MuX2001/cad-piper-paxini-adaptor/drawings/screenshots/piper_dual_m2324-v2_mount_detail.png

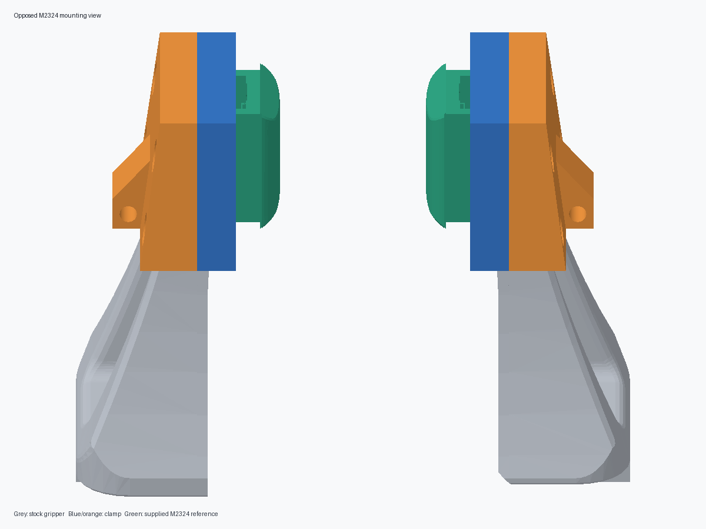
drawings/screenshots/piper_dual_m2324-v2_mount_detail.png
