MuX2001/cad-piper-paxini-adaptor/drawings/screenshots/piper_m2324-v2_section.png

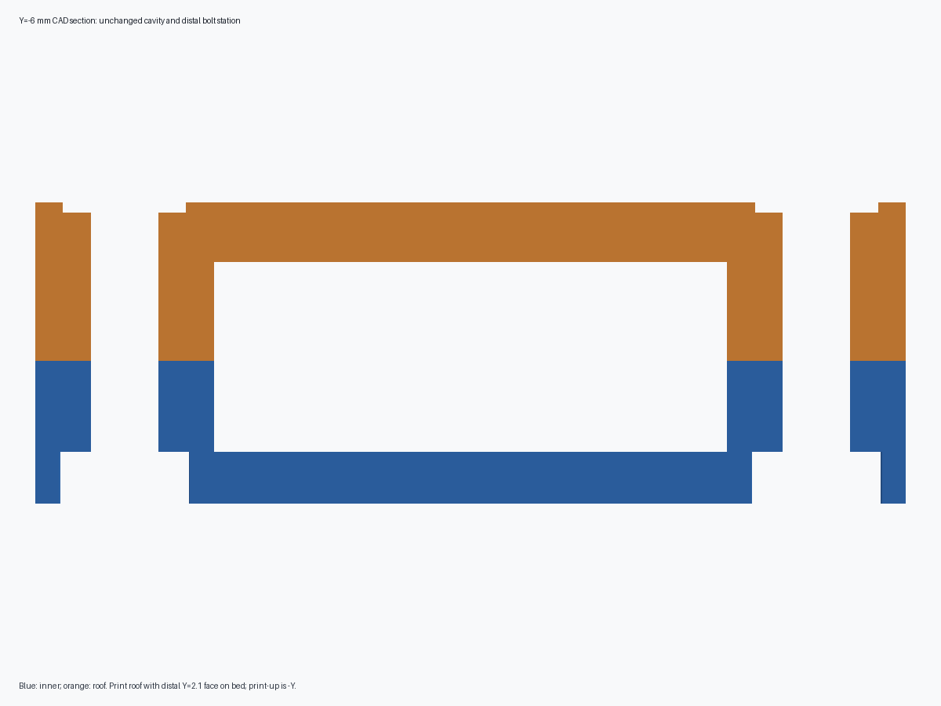
drawings/screenshots/piper_m2324-v2_section.png
