MuX2001/cad-piper-paxini-adaptor/v2/drawings/cable_routing.png

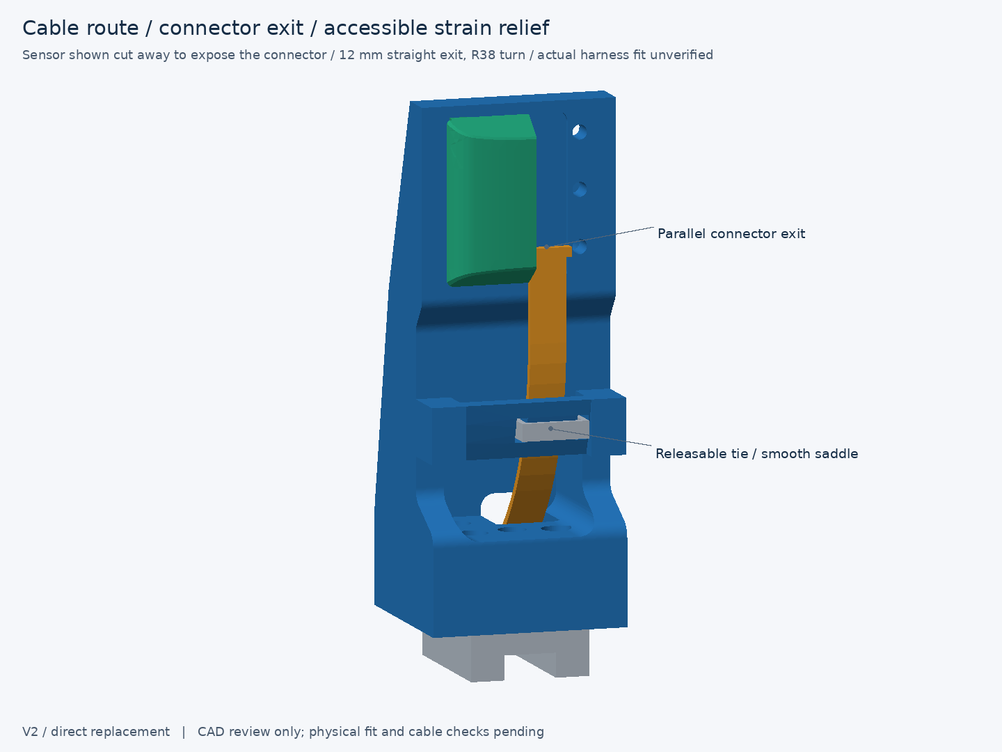
v2/drawings/cable_routing.png
