MuX2001/cad-piper-paxini-adaptor/v2/drawings/sensor_mount.png

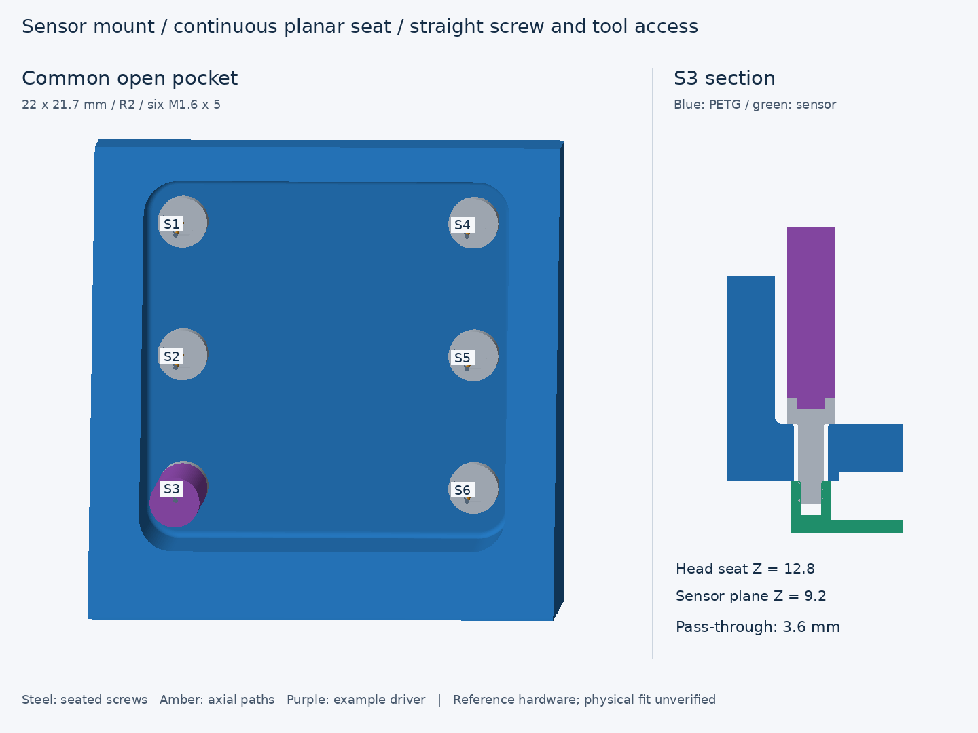
v2/drawings/sensor_mount.png
