MuX2001/cad-piper-paxini-adaptor/assets/vendor_files/agx_arm_urdf-main/agx_gripper/meshes/gripper_base.stl

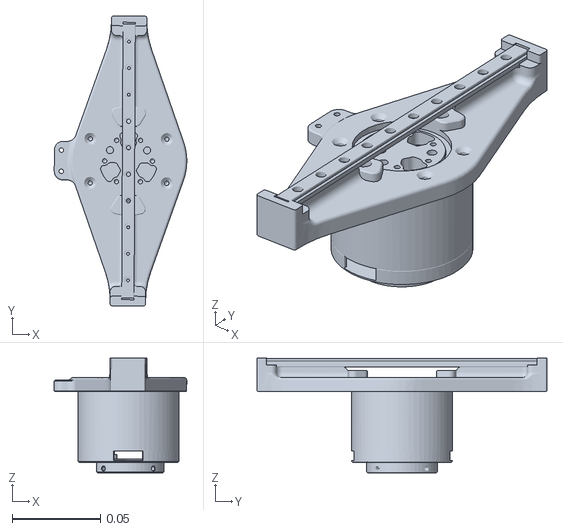
[picture p9: CAD file, 2026-10-11]
assets/vendor_files/agx_arm_urdf-main/agx_gripper/meshes/gripper_base.stl
0.075 x 0.164 x 0.065
