MuX2001/cad-piper-paxini-adaptor/assets/vendor_files/agx_arm_urdf-main/nero/meshes/link7.stl

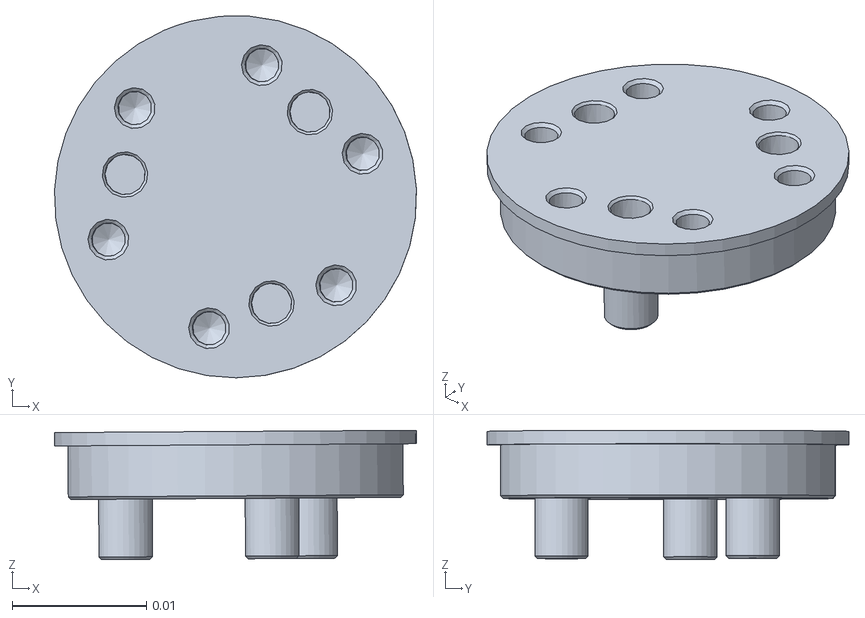
[picture p10: CAD file, 2026-10-11]
assets/vendor_files/agx_arm_urdf-main/nero/meshes/link7.stl
0.027 x 0.027 x 0.00965
