MuX2001/cad-piper-paxini-adaptor/assets/vendor_files/agx_arm_urdf-main/piper/meshes/link2.stl

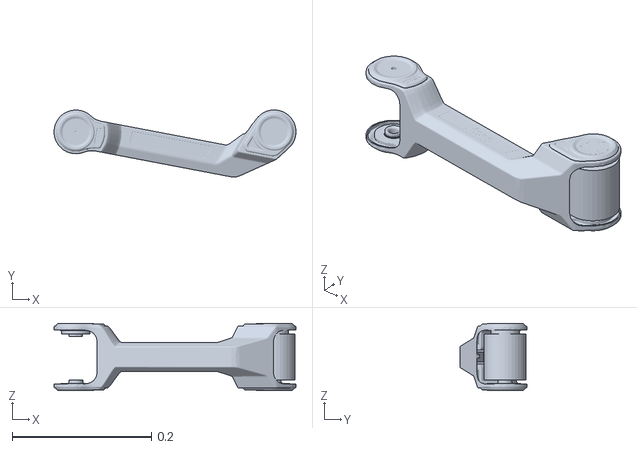
[picture p11: CAD file, 2026-10-11]
assets/vendor_files/agx_arm_urdf-main/piper/meshes/link2.stl
0.348 x 0.0965 x 0.097
