MuX2001/cad-piper-paxini-adaptor/assets/vendor_files/agx_arm_urdf-main/piper_h/meshes/link4.stl

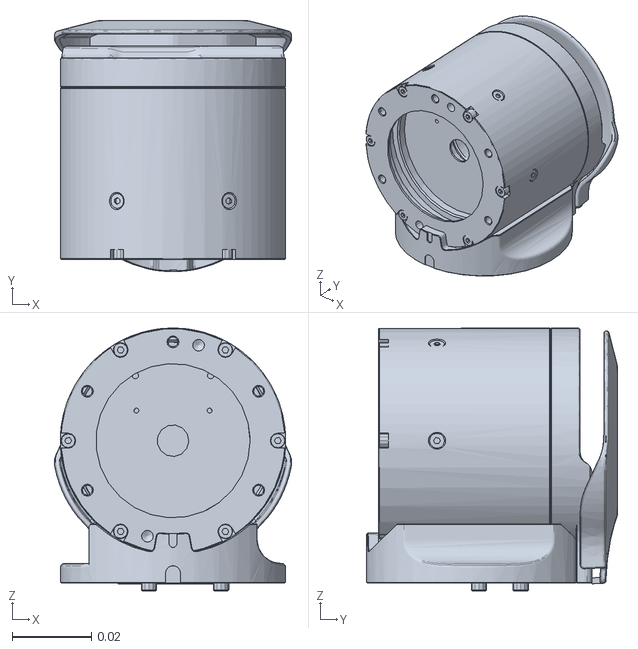
[picture p12: CAD file, 2026-10-11]
assets/vendor_files/agx_arm_urdf-main/piper_h/meshes/link4.stl
0.06 x 0.0636 x 0.0665
