MuX2001/cad-piper-paxini-adaptor/assets/vendor_files/agx_arm_urdf-main/piper_l/meshes/link5.stl

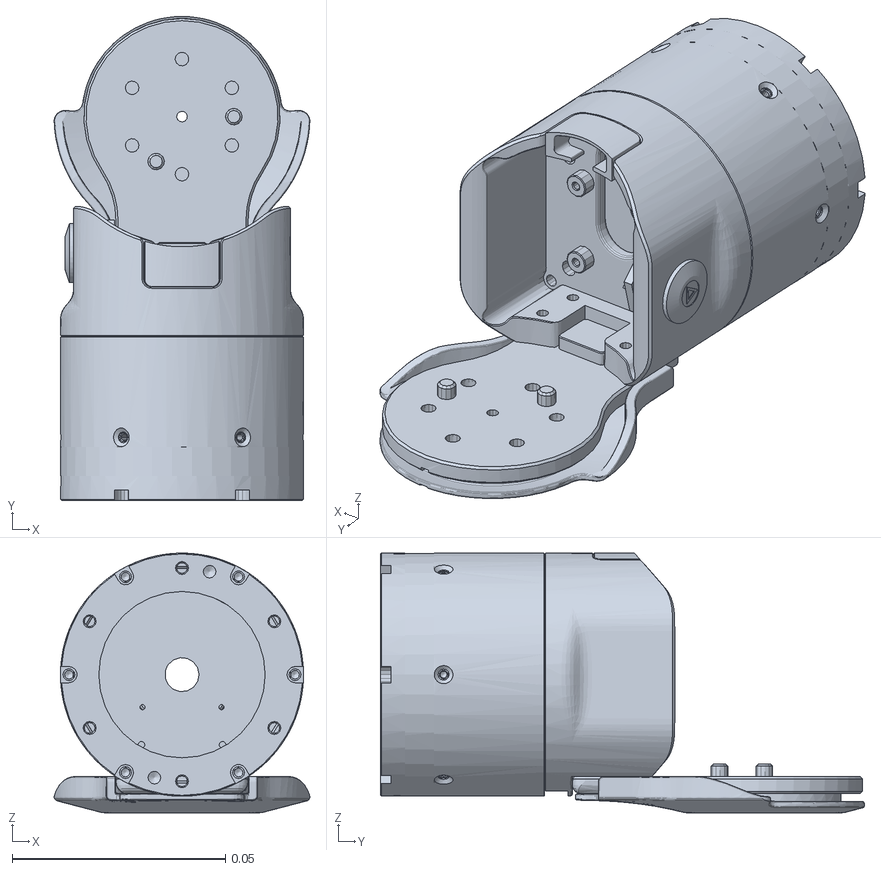
[picture p13: CAD file, 2026-10-11]
assets/vendor_files/agx_arm_urdf-main/piper_l/meshes/link5.stl
0.06 x 0.113 x 0.0609
