MuX2001/cad-piper-paxini-adaptor/assets/vendor_files/agx_arm_urdf-main/piper_x/meshes/link3.stl

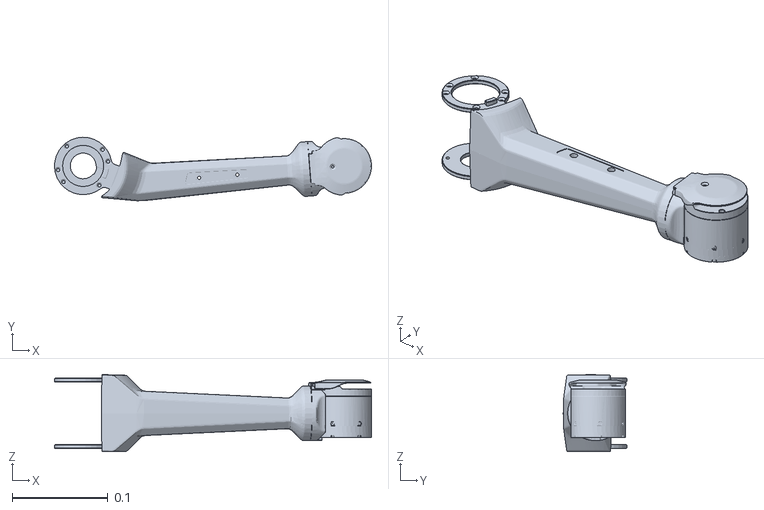
[picture p14: CAD file, 2026-10-11]
assets/vendor_files/agx_arm_urdf-main/piper_x/meshes/link3.stl
0.331 x 0.0664 x 0.0807
