MuX2001/cad-piper-paxini-adaptor/assets/vendor_files/agx_arm_urdf-main/revo2/meshes/revo2_left_hand/left_thumb_proximal_visual_link.STL

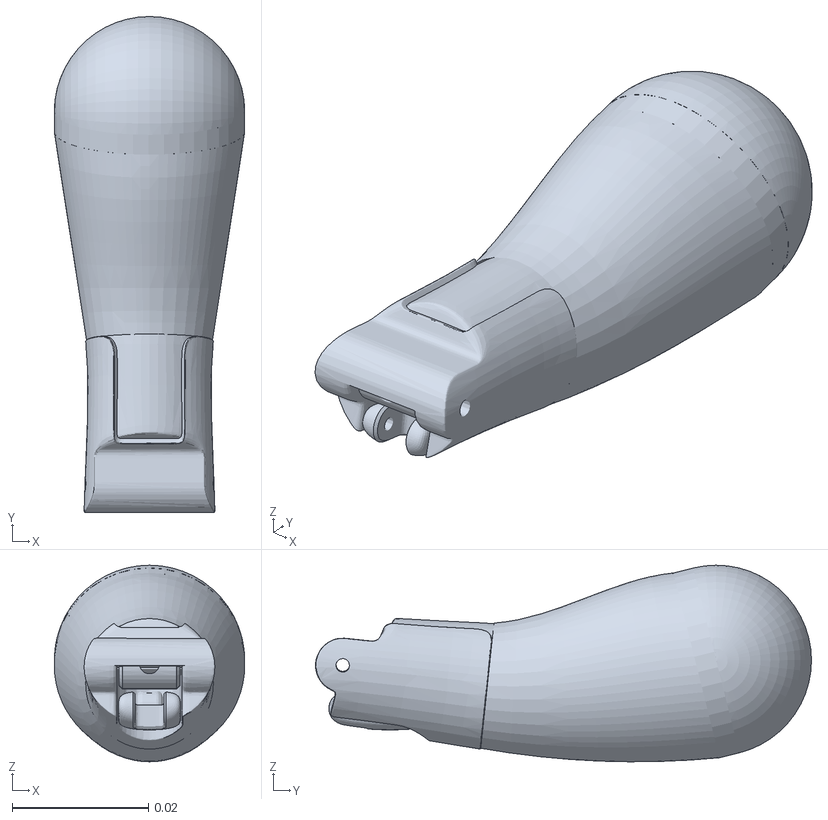
[picture p15: CAD file, 2026-10-11]
assets/vendor_files/agx_arm_urdf-main/revo2/meshes/revo2_left_hand/left_thumb_proximal_visual_link.STL
0.028 x 0.0729 x 0.0289
