MuX2001/cad-piper-paxini-adaptor/assets/vendor_files/agx_arm_urdf-main/revo2/meshes/revo2_right_hand/right_pinky_tip.STL

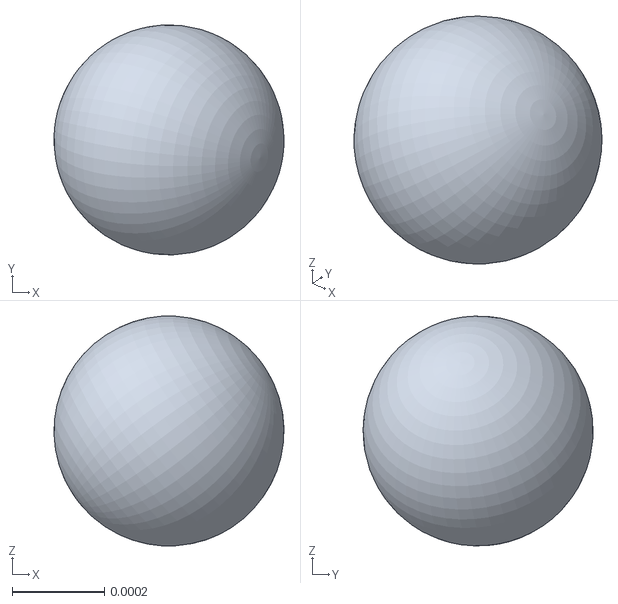
[picture p16: CAD file, 2026-10-11]
assets/vendor_files/agx_arm_urdf-main/revo2/meshes/revo2_right_hand/right_pinky_tip.STL
0.0005 x 0.000499 x 0.000499
