MuX2001/cad-piper-paxini-adaptor/assets/vendor_files/GEN3触觉传感器3D模型/3D Models 3D图纸/Fingertip 指尖 26mm PX6AX-GEN3-DP-M2826-Omega PXSR-STDDP03B.stp

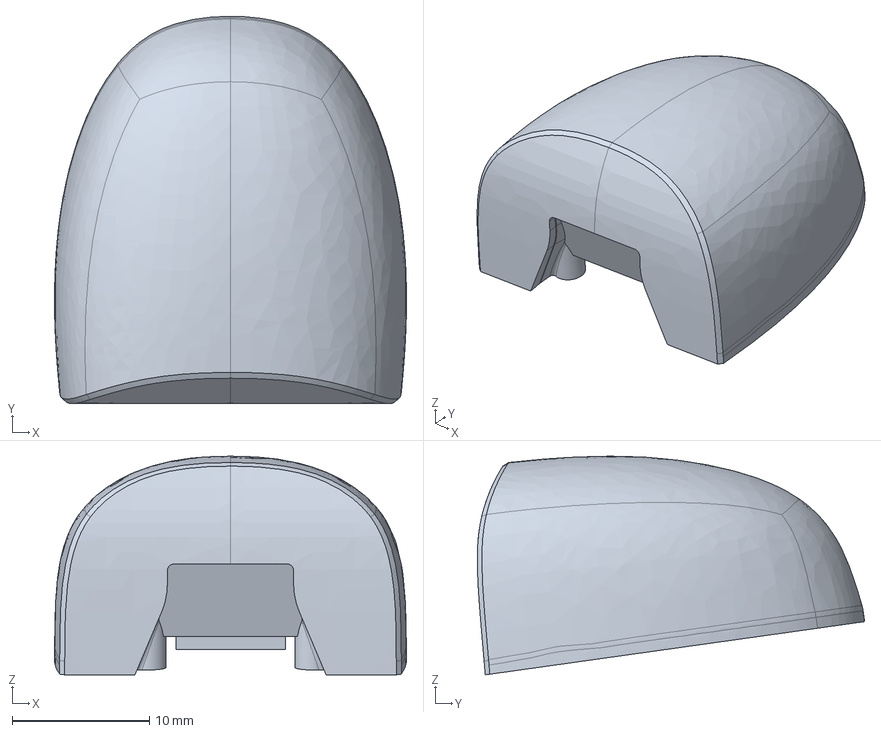
[picture p17: CAD file, 2026-10-11]
assets/vendor_files/GEN3触觉传感器3D模型/3D Models 3D图纸/Fingertip 指尖 26mm PX6AX-GEN3-DP-M2826-Omega PXSR-STDDP03B.stp
25.7 x 28.3 x 16.0 mm
