MuX2001/cad-piper-paxini-adaptor/cad/exported/piper_m2324-v2_fastener_coupon.step

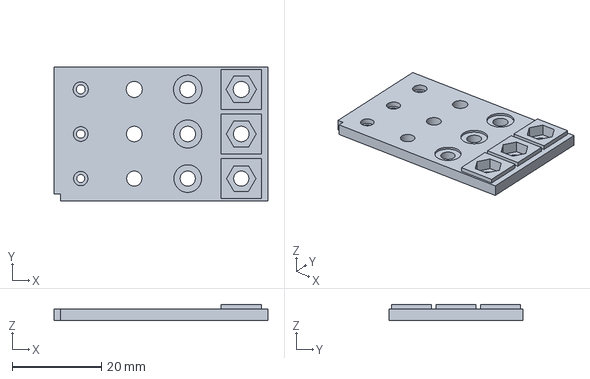
[picture p18: CAD file, 2026-10-12]
cad/exported/piper_m2324-v2_fastener_coupon.step
48.0 x 30.0 x 3.60 mm
