MuX2001/cad-piper-paxini-adaptor/v2/cad/exported/replacement_finger_print.stl

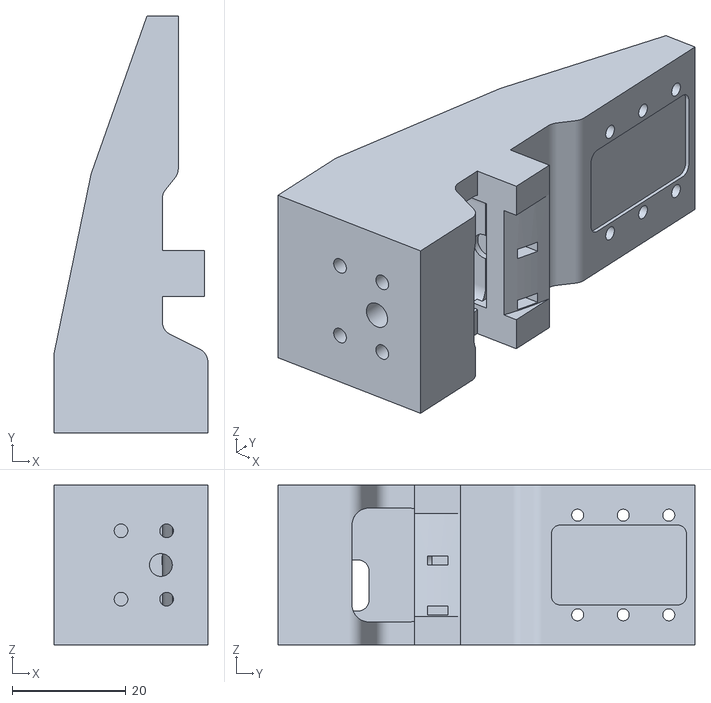
[picture p19: CAD file, 2026-10-16]
v2/cad/exported/replacement_finger_print.stl
27.0 x 73.2 x 28.0
