MuX2001/cad-piper-paxini-adaptor/v2/revisions/before-printability-audit/cad/exported/fastener_coupon_print.stl

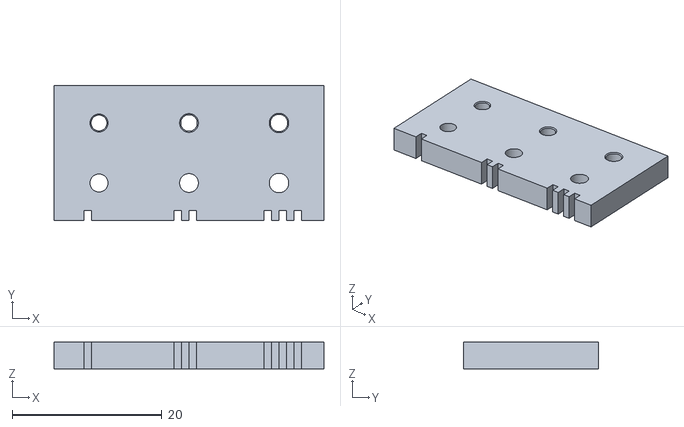
[picture p20: CAD file, 2026-10-16]
v2/revisions/before-printability-audit/cad/exported/fastener_coupon_print.stl
36.0 x 18.0 x 3.60
