MuX2001/cad-piper-paxini-adaptor/v2/revisions/goal-02/cad/exported/mount_fit_gauge.step

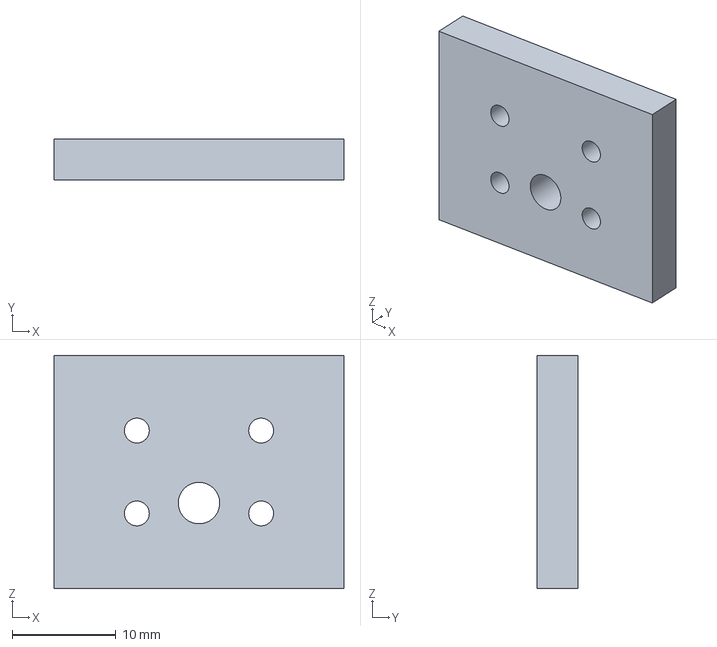
[picture p22: CAD file, 2026-10-16]
v2/revisions/goal-02/cad/exported/mount_fit_gauge.step
28.0 x 4.00 x 22.5 mm
