MuX2001/cad-piper-paxini-adaptor/assets/vendor_files/agx_arm_urdf-main/agx_gripper/meshes/gripper_link1.stl

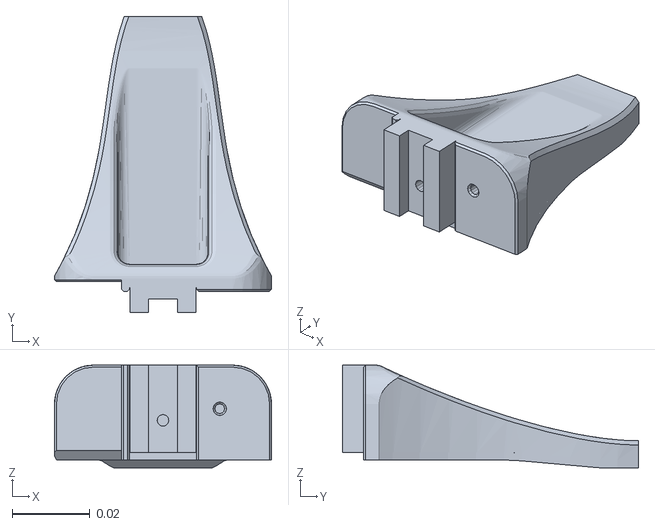
[picture p23: CAD file, 2026-10-11]
assets/vendor_files/agx_arm_urdf-main/agx_gripper/meshes/gripper_link1.stl
0.056 x 0.0765 x 0.0265
