MuX2001/cad-piper-paxini-adaptor/assets/vendor_files/agx_arm_urdf-main/nero/meshes/link5.stl

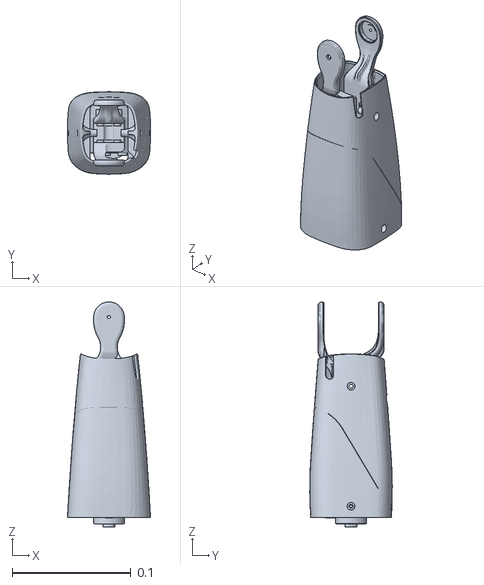
[picture p24: CAD file, 2026-10-11]
assets/vendor_files/agx_arm_urdf-main/nero/meshes/link5.stl
0.07 x 0.0695 x 0.189
