MuX2001/cad-piper-paxini-adaptor/assets/vendor_files/GEN3触觉传感器3D模型/3D Models 3D图纸/Finger pad 指腹 M3025 PX6AX-GEN3-CP-M3025-Core PXSR-STDCP03B.stp

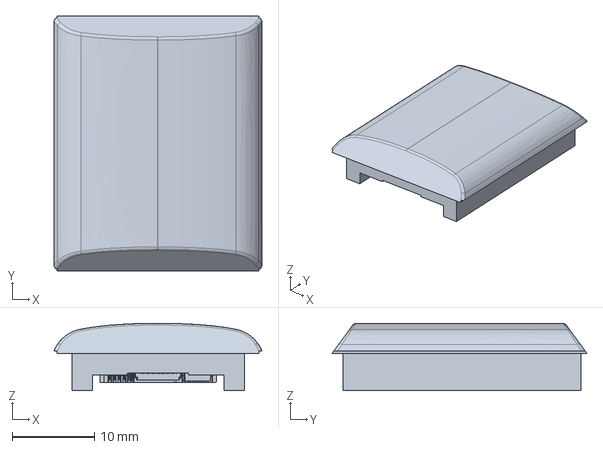
[picture p29: CAD file, 2026-10-11]
assets/vendor_files/GEN3触觉传感器3D模型/3D Models 3D图纸/Finger pad 指腹 M3025 PX6AX-GEN3-CP-M3025-Core PXSR-STDCP03B.stp
25.3 x 31.0 x 8.20 mm
