MuX2001/cad-piper-paxini-adaptor/cad/exported/piper_m2324-v2_fit_gauge_roof_print.stl

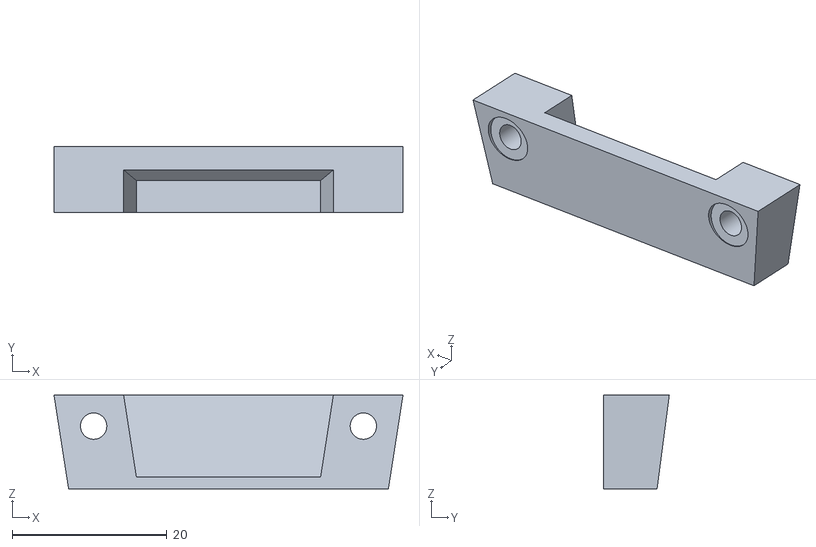
[picture p30: CAD file, 2026-10-12]
cad/exported/piper_m2324-v2_fit_gauge_roof_print.stl
45.1 x 8.48 x 12.1
