MuX2001/cad-piper-paxini-adaptor/v2/cad/exported/cable_routing_open50.step

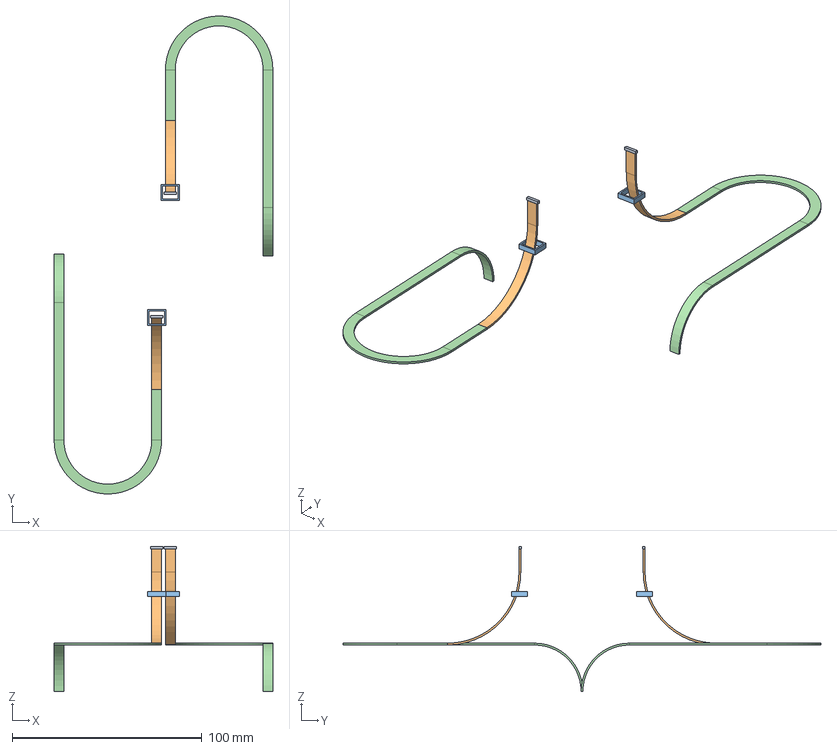
[picture p31: CAD file, 2026-10-16]
v2/cad/exported/cable_routing_open50.step
115.2 x 251.6 x 76.4 mm
DF53_exposed_plug_1
moving_harness_envelope_1
releasable_tie_envelope_1
service_loop_envelope_1
DF53_exposed_plug_2
moving_harness_envelope_2
releasable_tie_envelope_2
service_loop_envelope_2
