MuX2001/cad-piper-paxini-adaptor/assets/vendor_files/agx_arm_urdf-main/nero/meshes/link2.stl

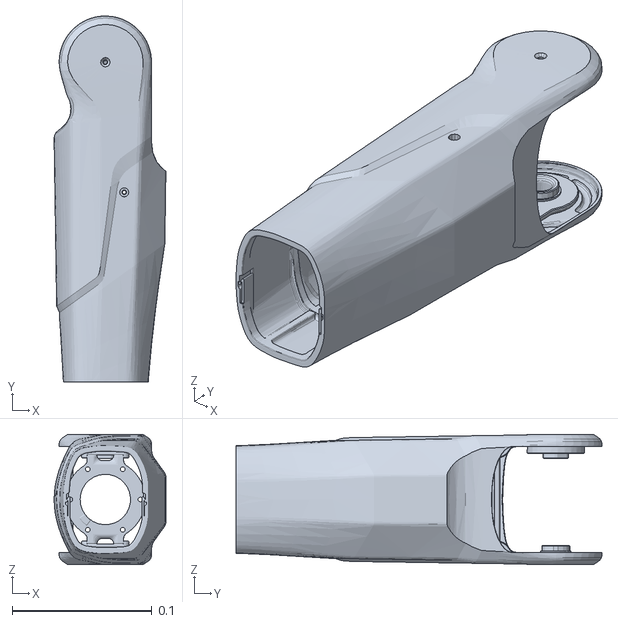
[picture p35: CAD file, 2026-10-11]
assets/vendor_files/agx_arm_urdf-main/nero/meshes/link2.stl
0.0799 x 0.261 x 0.0931
