MuX2001/cad-piper-paxini-adaptor/assets/vendor_files/agx_arm_urdf-main/piper/meshes/link3.stl

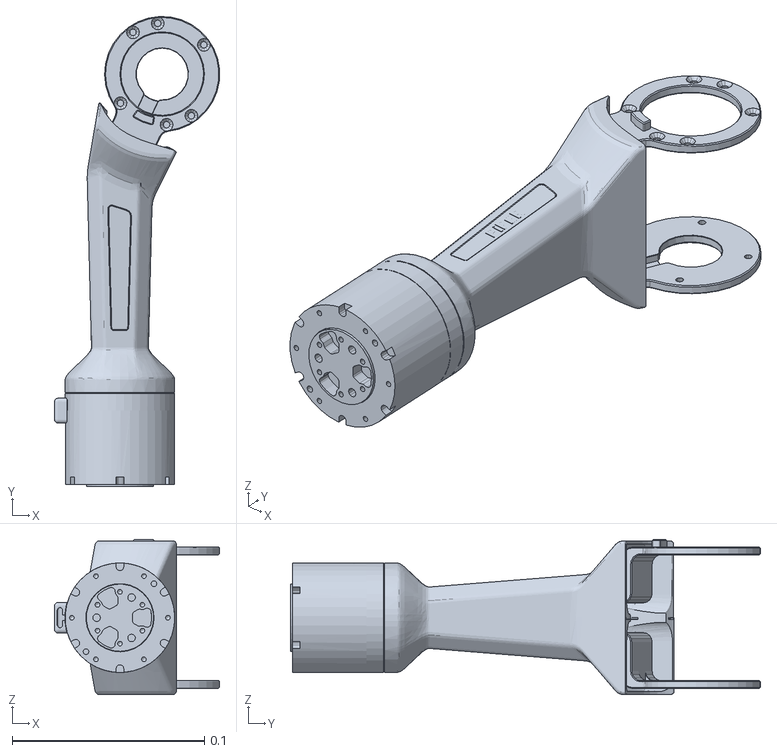
[picture p36: CAD file, 2026-10-11]
assets/vendor_files/agx_arm_urdf-main/piper/meshes/link3.stl
0.0861 x 0.245 x 0.0807
