MuX2001/cad-piper-paxini-adaptor/assets/vendor_files/agx_arm_urdf-main/piper_h/meshes/link2.stl

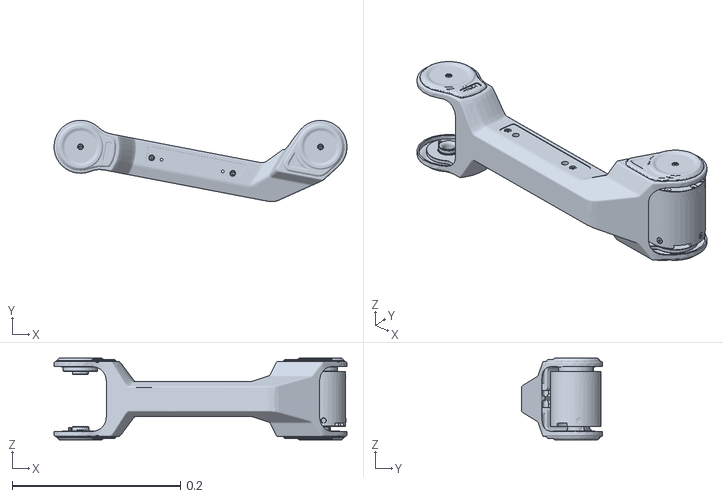
[picture p37: CAD file, 2026-10-11]
assets/vendor_files/agx_arm_urdf-main/piper_h/meshes/link2.stl
0.348 x 0.0966 x 0.097
