MuX2001/cad-piper-paxini-adaptor/assets/vendor_files/agx_arm_urdf-main/piper_x/meshes/link6.stl

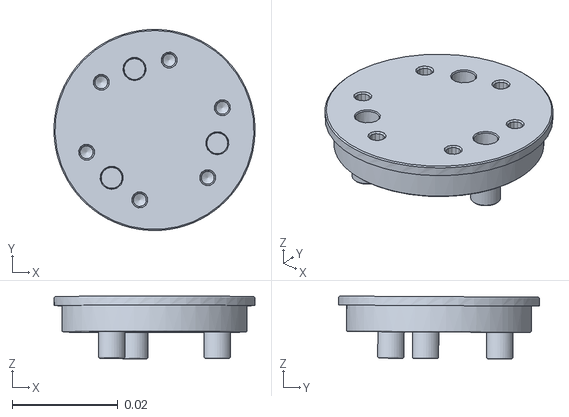
[picture p39: CAD file, 2026-10-11]
assets/vendor_files/agx_arm_urdf-main/piper_x/meshes/link6.stl
0.038 x 0.038 x 0.0119
