MuX2001/cad-piper-paxini-adaptor/assets/vendor_files/agx_arm_urdf-main/revo2/meshes/revo2_left_hand/left_middle_touch_link.STL

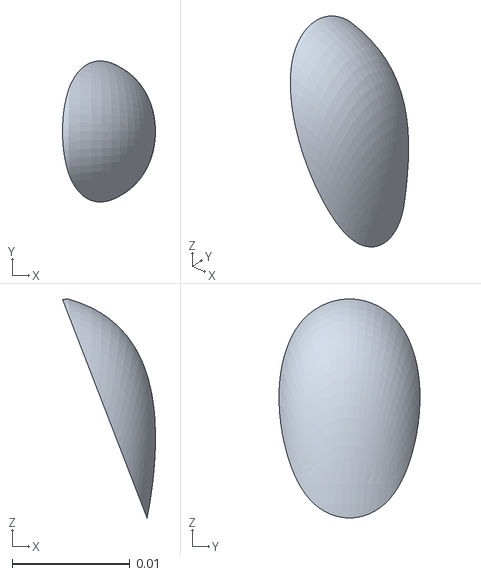
[picture p40: CAD file, 2026-10-11]
assets/vendor_files/agx_arm_urdf-main/revo2/meshes/revo2_left_hand/left_middle_touch_link.STL
0.00789 x 0.012 x 0.0186
