MuX2001/cad-piper-paxini-adaptor/assets/vendor_files/agx_arm_urdf-main/revo2/meshes/revo2_right_hand/right_thumb_distal_link.STL

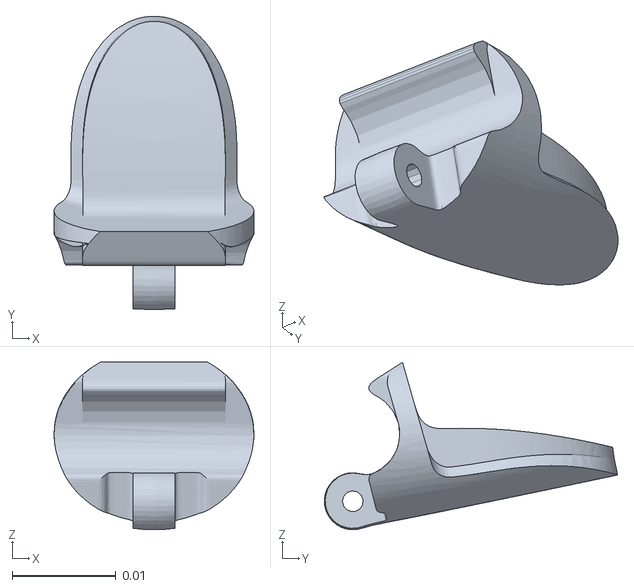
[picture p41: CAD file, 2026-10-11]
assets/vendor_files/agx_arm_urdf-main/revo2/meshes/revo2_right_hand/right_thumb_distal_link.STL
0.0193 x 0.0283 x 0.0161
