MuX2001/cad-piper-paxini-adaptor/cad/exported/piper_m2324-v2_fit_gauge_inner.step

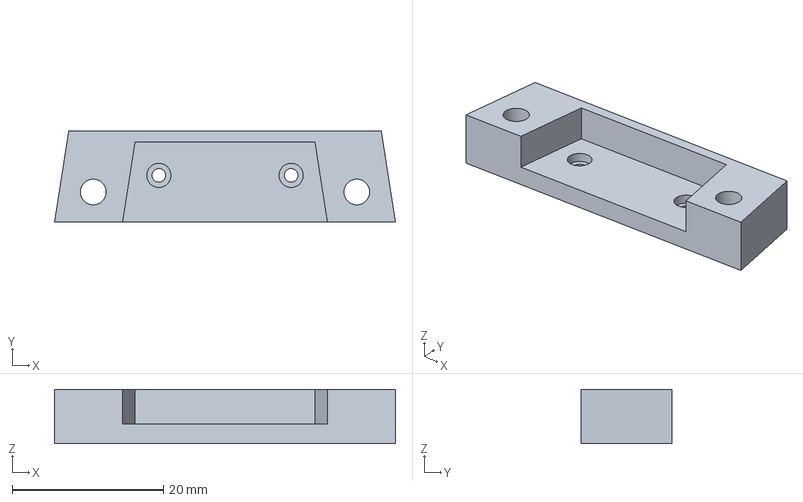
[picture p43: CAD file, 2026-10-12]
cad/exported/piper_m2324-v2_fit_gauge_inner.step
45.1 x 12.1 x 7.20 mm
