MuX2001/cad-piper-paxini-adaptor/v2/revisions/before-shallow-counterbores/cad/exported/mount_fit_gauge.step

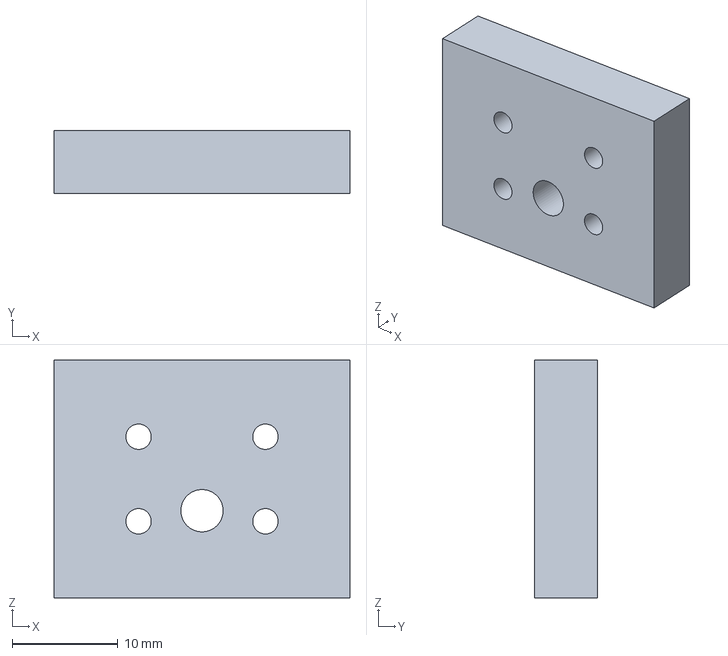
[picture p44: CAD file, 2026-10-16]
v2/revisions/before-shallow-counterbores/cad/exported/mount_fit_gauge.step
28.0 x 6.00 x 22.5 mm
