MuX2001/cad-piper-paxini-adaptor/v2/revisions/before-short-sensor-pads/cad/exported/finger_sensor_pair_open50.step

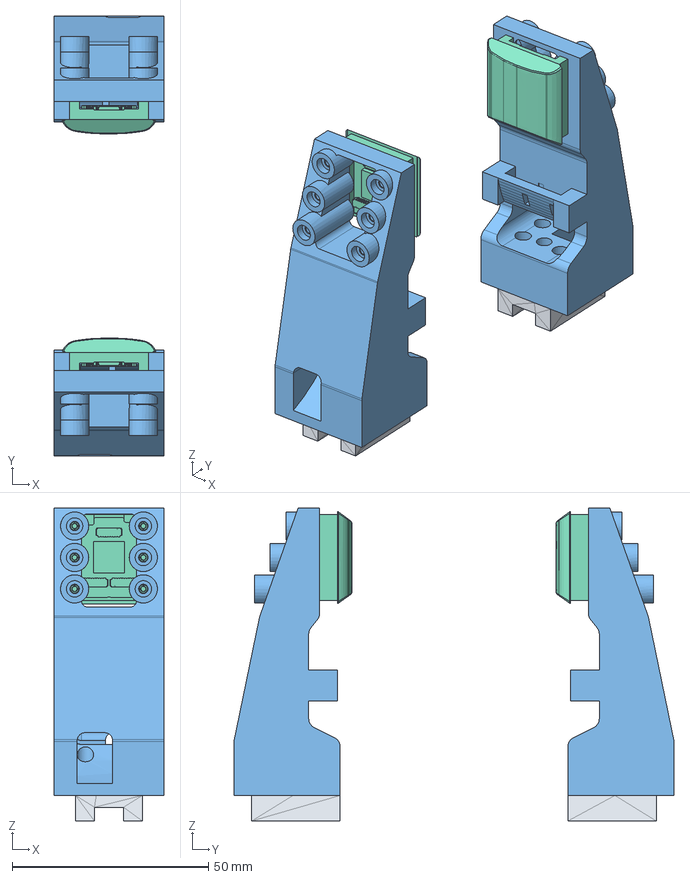
[picture p45: CAD file, 2026-10-16]
v2/revisions/before-short-sensor-pads/cad/exported/finger_sensor_pair_open50.step
28.0 x 112.0 x 79.7 mm
replacement_finger_1
M2324_1
retained_carrier_faceted_1
replacement_finger_2
M2324_2
retained_carrier_faceted_2
