MuX2001/cad-piper-paxini-adaptor/v2/revisions/goal-02/cad/exported/replacement_finger_print.stl

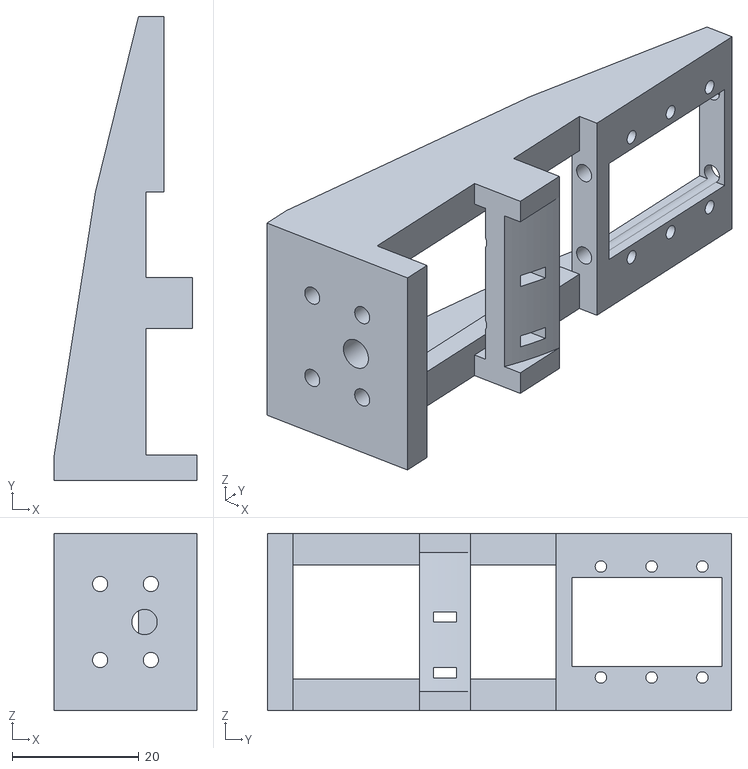
[picture p46: CAD file, 2026-10-16]
v2/revisions/goal-02/cad/exported/replacement_finger_print.stl
22.5 x 73.2 x 28.0
