MuX2001/cad-piper-paxini-adaptor/assets/vendor_files/agx_arm_urdf-main/nero/meshes/link3.stl

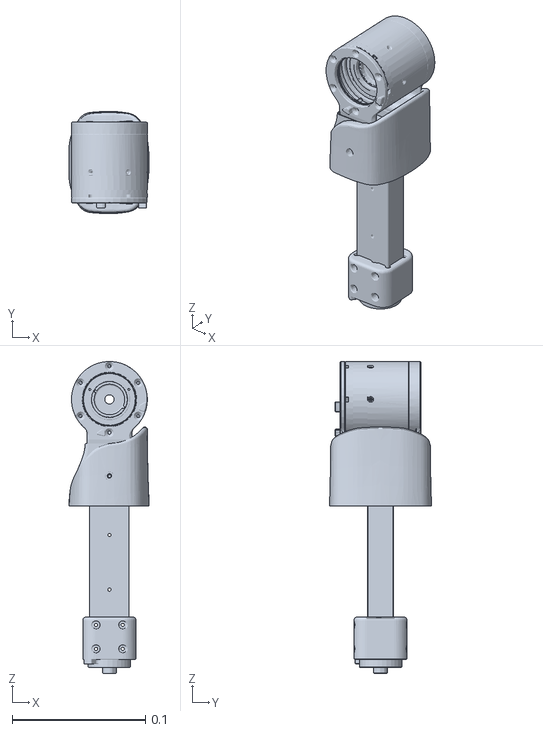
[picture p47: CAD file, 2026-10-11]
assets/vendor_files/agx_arm_urdf-main/nero/meshes/link3.stl
0.0604 x 0.0768 x 0.235
