MuX2001/cad-piper-paxini-adaptor/assets/vendor_files/agx_arm_urdf-main/piper/meshes/link4.stl

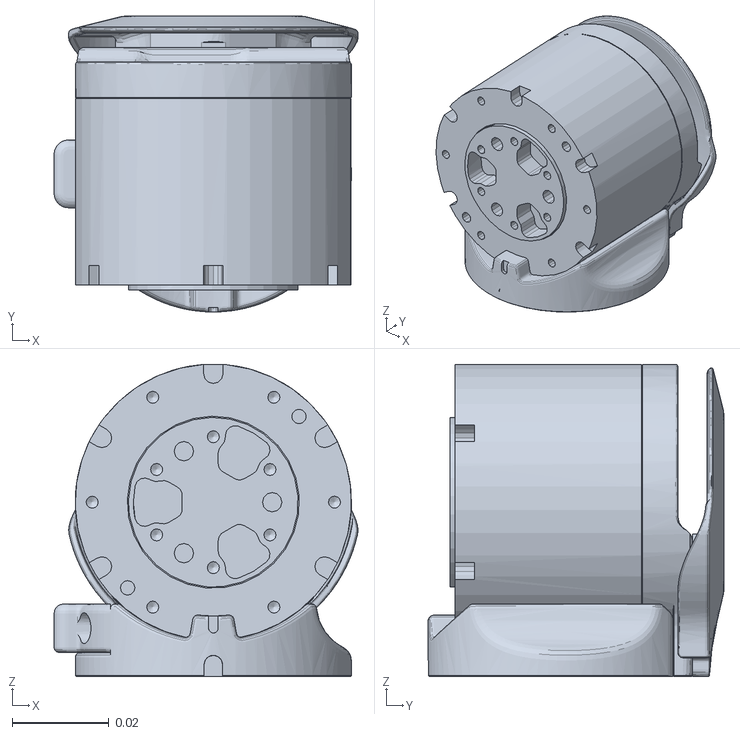
[picture p48: CAD file, 2026-10-11]
assets/vendor_files/agx_arm_urdf-main/piper/meshes/link4.stl
0.0627 x 0.0611 x 0.0644
