MuX2001/cad-piper-paxini-adaptor/assets/vendor_files/agx_arm_urdf-main/piper_h/meshes/link3.stl

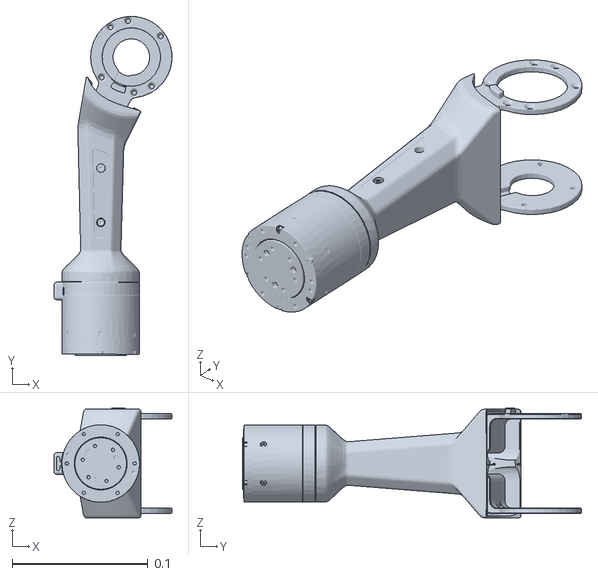
[picture p49: CAD file, 2026-10-11]
assets/vendor_files/agx_arm_urdf-main/piper_h/meshes/link3.stl
0.0869 x 0.25 x 0.0807
