MuX2001/cad-piper-paxini-adaptor/assets/vendor_files/agx_arm_urdf-main/piper_l/meshes/flange.stl

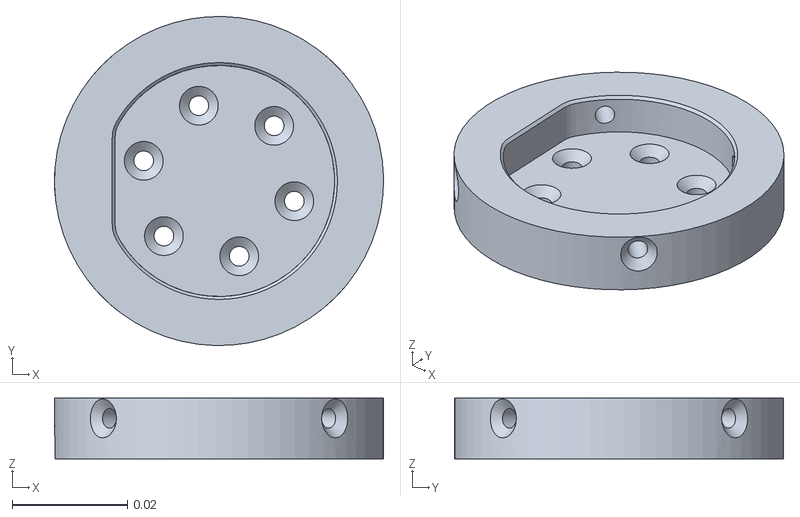
[picture p50: CAD file, 2026-10-11]
assets/vendor_files/agx_arm_urdf-main/piper_l/meshes/flange.stl
0.057 x 0.057 x 0.0105
