MuX2001/cad-piper-paxini-adaptor/assets/vendor_files/GEN3触觉传感器3D模型/3D Models 3D图纸/Fingertip 指尖 30mm PX6AX-GEN3-DP-L3530-Omega PXSR-STDDP03A.stp

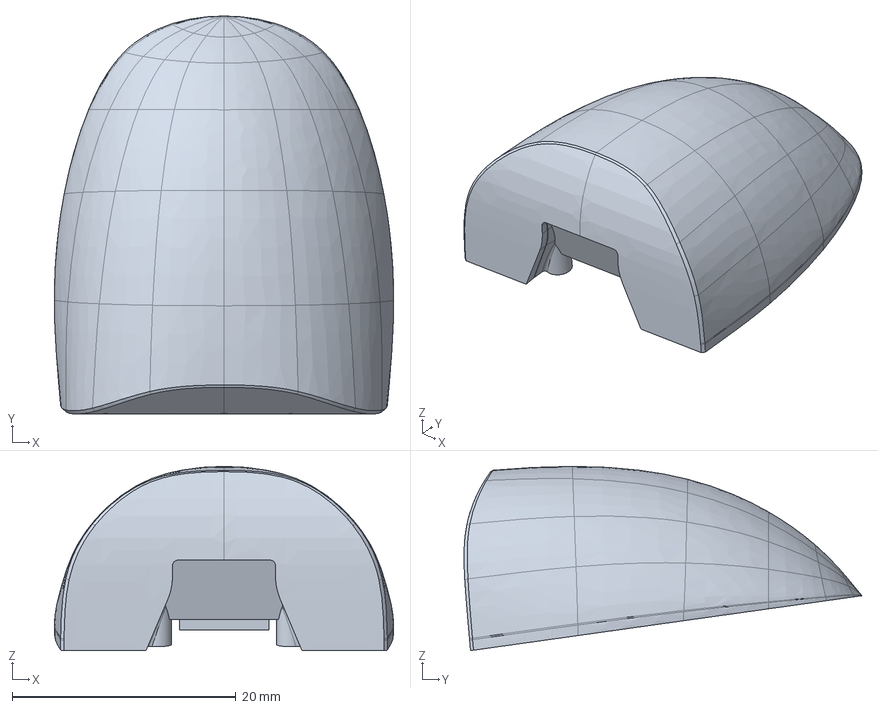
[picture p52: CAD file, 2026-10-11]
assets/vendor_files/GEN3触觉传感器3D模型/3D Models 3D图纸/Fingertip 指尖 30mm PX6AX-GEN3-DP-L3530-Omega PXSR-STDDP03A.stp
30.3 x 35.6 x 16.5 mm
