MuX2001/cad-piper-paxini-adaptor/v2/revisions/goal-02/cad/exported/mount_fit_gauge_print.stl

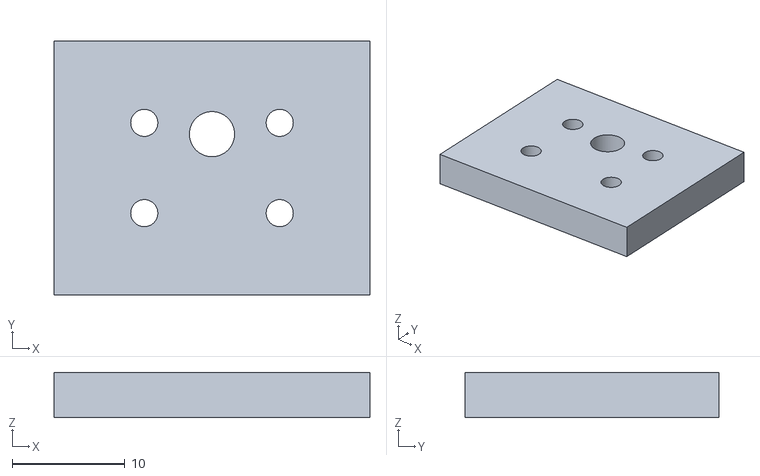
[picture p53: CAD file, 2026-10-16]
v2/revisions/goal-02/cad/exported/mount_fit_gauge_print.stl
28.0 x 22.5 x 4.00
