MuX2001/cad-piper-paxini-adaptor/assets/vendor_files/agx_arm_urdf-main/nero/meshes/base_link.stl

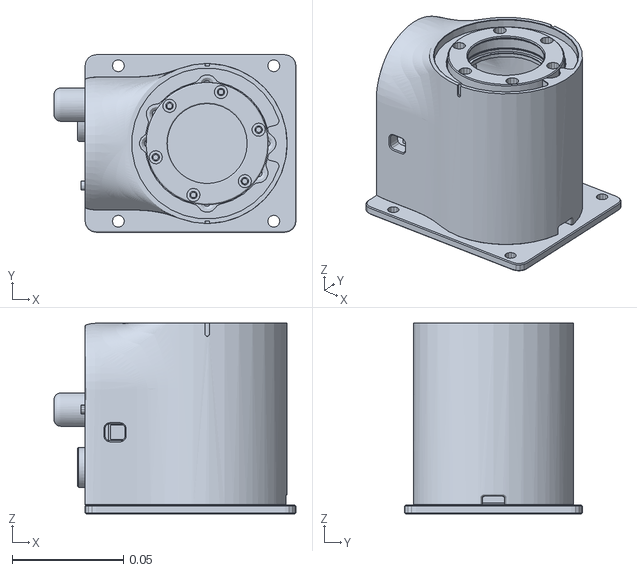
[picture p54: CAD file, 2026-10-11]
assets/vendor_files/agx_arm_urdf-main/nero/meshes/base_link.stl
0.109 x 0.08 x 0.086
