MuX2001/cad-piper-paxini-adaptor/assets/vendor_files/agx_arm_urdf-main/piper/meshes/base_link.stl

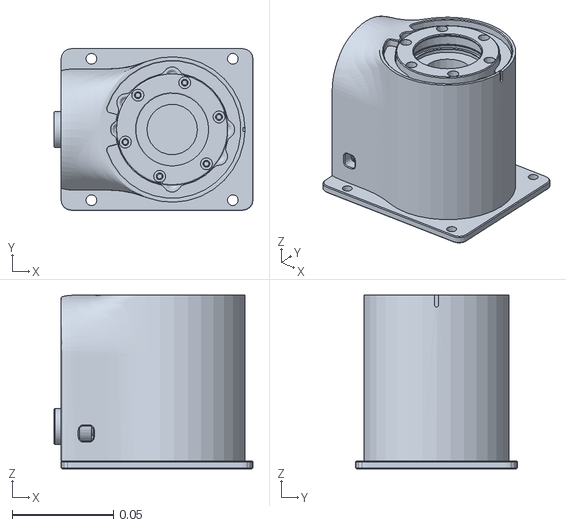
[picture p55: CAD file, 2026-10-11]
assets/vendor_files/agx_arm_urdf-main/piper/meshes/base_link.stl
0.0985 x 0.08 x 0.086
