MuX2001/cad-piper-paxini-adaptor/assets/vendor_files/agx_arm_urdf-main/revo2/meshes/revo2_left_hand/left_pinky_touch_link.STL

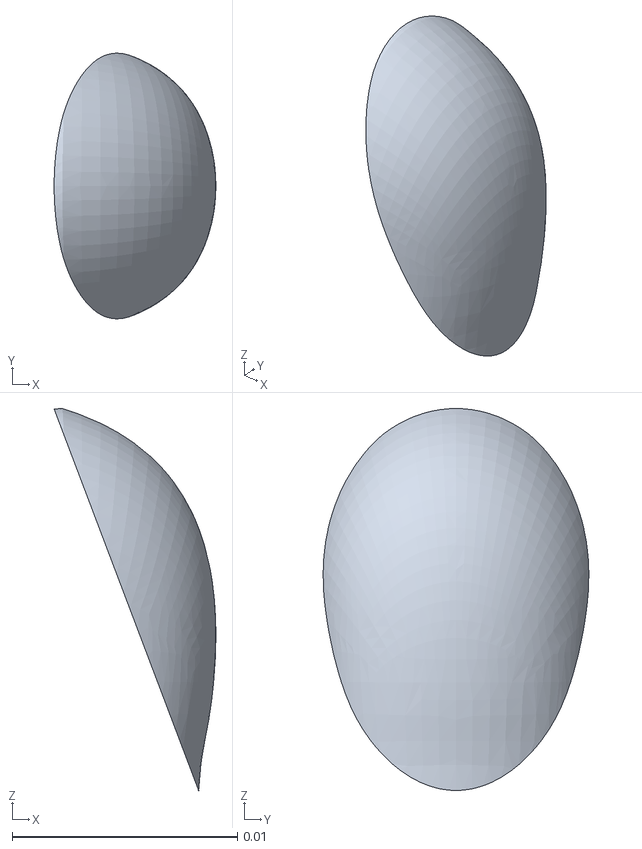
[picture p59: CAD file, 2026-10-11]
assets/vendor_files/agx_arm_urdf-main/revo2/meshes/revo2_left_hand/left_pinky_touch_link.STL
0.00718 x 0.0118 x 0.017
