MuX2001/cad-piper-paxini-adaptor/assets/vendor_files/agx_arm_urdf-main/revo2/meshes/revo2_right_hand/right_index_proximal_link.STL

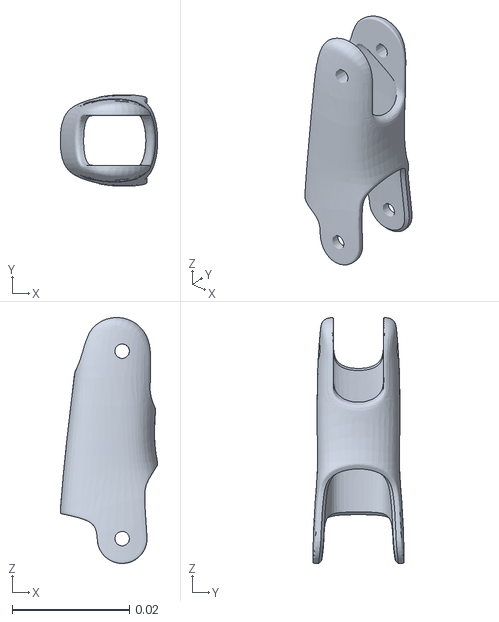
[picture p60: CAD file, 2026-10-11]
assets/vendor_files/agx_arm_urdf-main/revo2/meshes/revo2_right_hand/right_index_proximal_link.STL
0.0166 x 0.0156 x 0.042
