MuX2001/cad-piper-paxini-adaptor/assets/vendor_files/GEN3触觉传感器3D模型/3D Models 3D图纸/Fingertip 指尖 15mm PX6AX-GEN3-DP-S2015-Elite PXSR-STDDP03G.stp

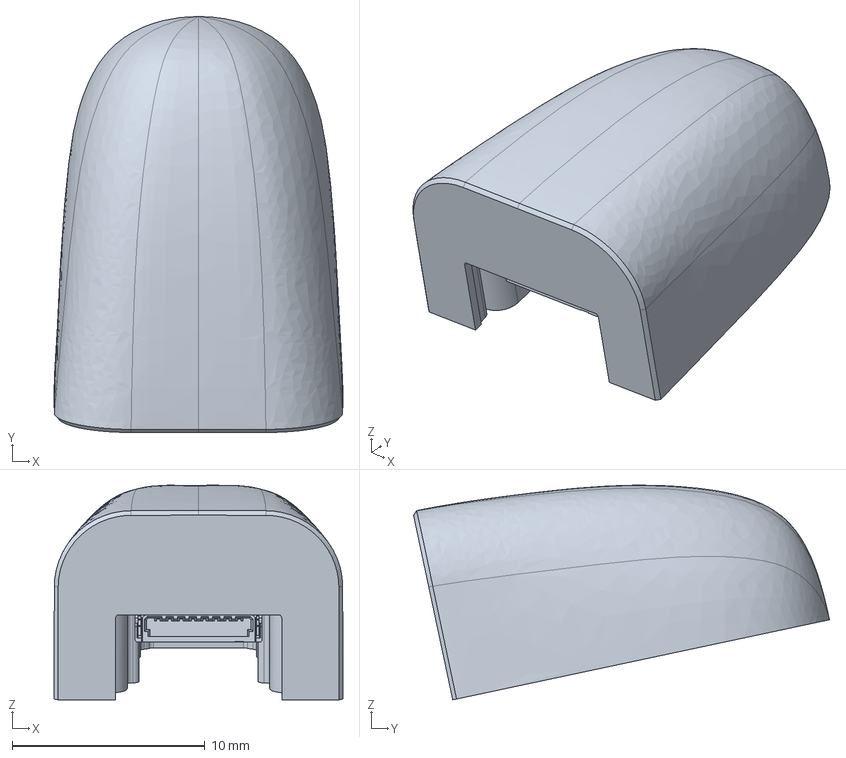
[picture p61: CAD file, 2026-10-11]
assets/vendor_files/GEN3触觉传感器3D模型/3D Models 3D图纸/Fingertip 指尖 15mm PX6AX-GEN3-DP-S2015-Elite PXSR-STDDP03G.stp
15.0 x 21.6 x 11.1 mm
