MuX2001/cad-piper-paxini-adaptor/cad/exported/piper_m2324-v2_outer_roof.step

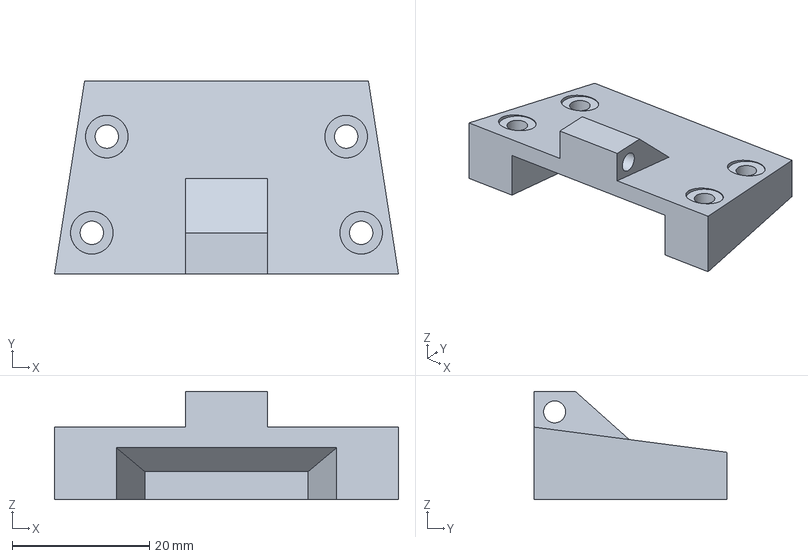
[picture p62: CAD file, 2026-10-12]
cad/exported/piper_m2324-v2_outer_roof.step
50.1 x 28.1 x 15.8 mm
