MuX2001/cad-piper-paxini-adaptor/assets/vendor_files/agx_arm_urdf-main/nero/meshes/link1.stl

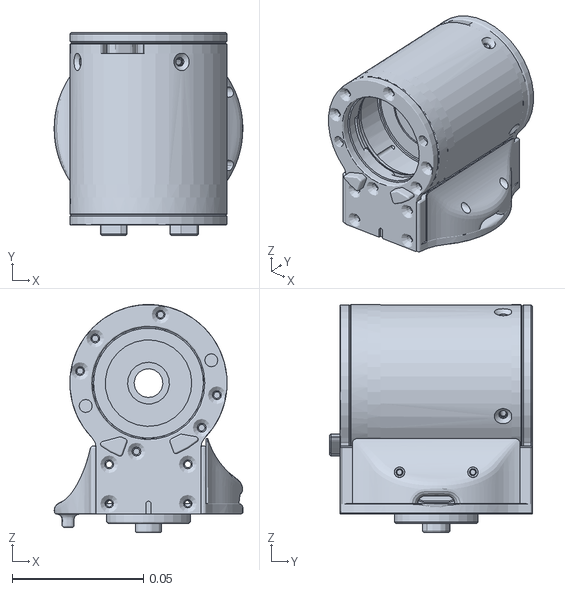
[picture p64: CAD file, 2026-10-11]
assets/vendor_files/agx_arm_urdf-main/nero/meshes/link1.stl
0.072 x 0.0775 x 0.087
