MuX2001/cad-piper-paxini-adaptor/assets/vendor_files/agx_arm_urdf-main/piper_x/meshes/link5.stl

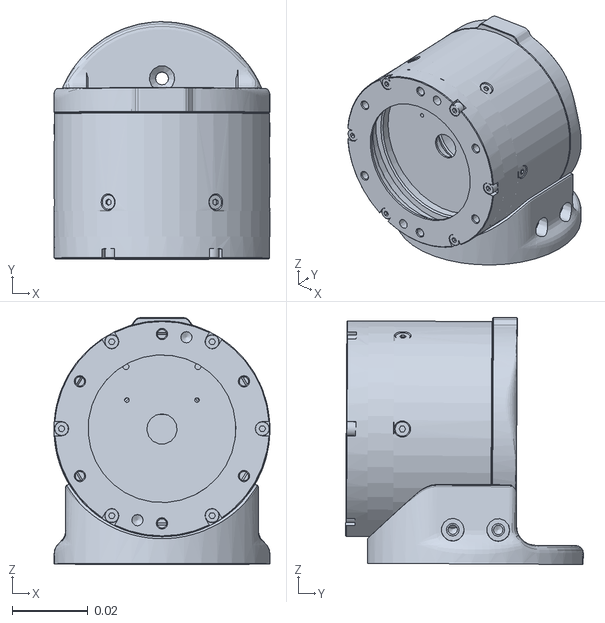
[picture p66: CAD file, 2026-10-11]
assets/vendor_files/agx_arm_urdf-main/piper_x/meshes/link5.stl
0.057 x 0.0627 x 0.0652
