MuX2001/cad-piper-paxini-adaptor/assets/vendor_files/GEN3触觉传感器3D模型/3D Models 3D图纸/Fingertip 指尖 16mm PX6AX-GEN3-DP-S2716-Core PXSR-STDDP03C.stp

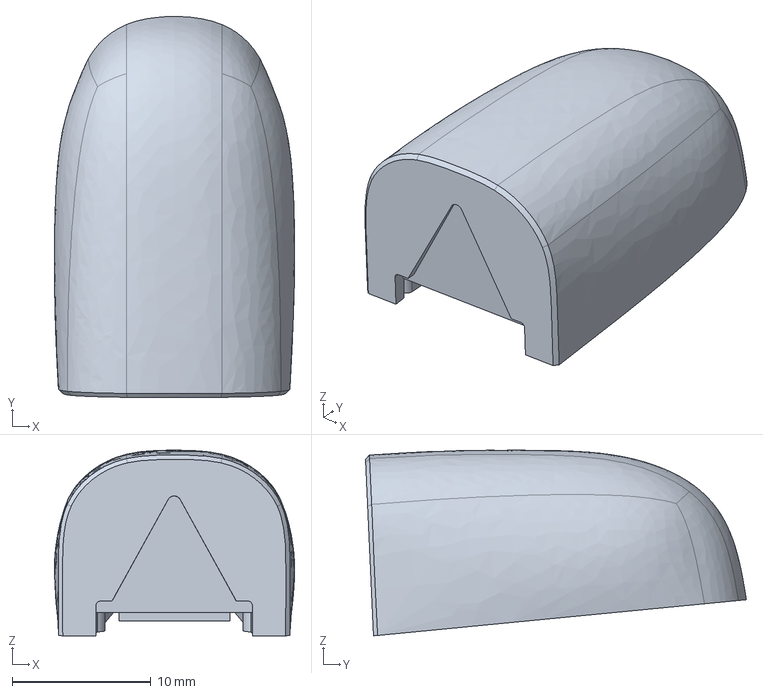
[picture p67: CAD file, 2026-10-11]
assets/vendor_files/GEN3触觉传感器3D模型/3D Models 3D图纸/Fingertip 指尖 16mm PX6AX-GEN3-DP-S2716-Core PXSR-STDDP03C.stp
17.3 x 27.4 x 13.4 mm
