MuX2001/cad-piper-paxini-adaptor/cad/exported/piper_m2324-v2_inner_plate.step

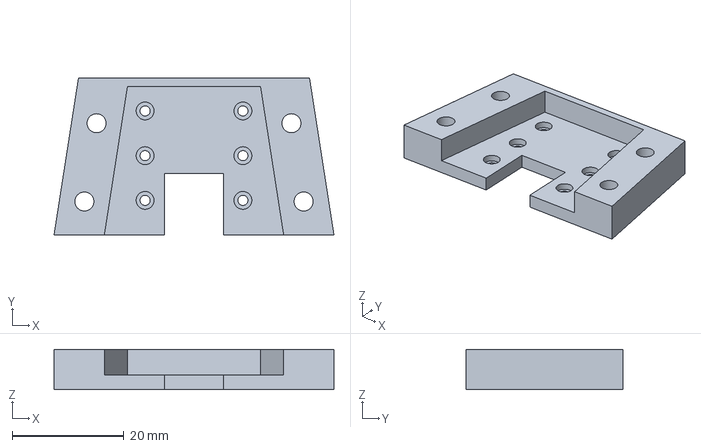
[picture p68: CAD file, 2026-10-12]
cad/exported/piper_m2324-v2_inner_plate.step
50.1 x 28.1 x 7.20 mm
