MuX2001/cad-piper-paxini-adaptor/assets/vendor_files/agx_arm_urdf-main/nero/meshes/link4.stl

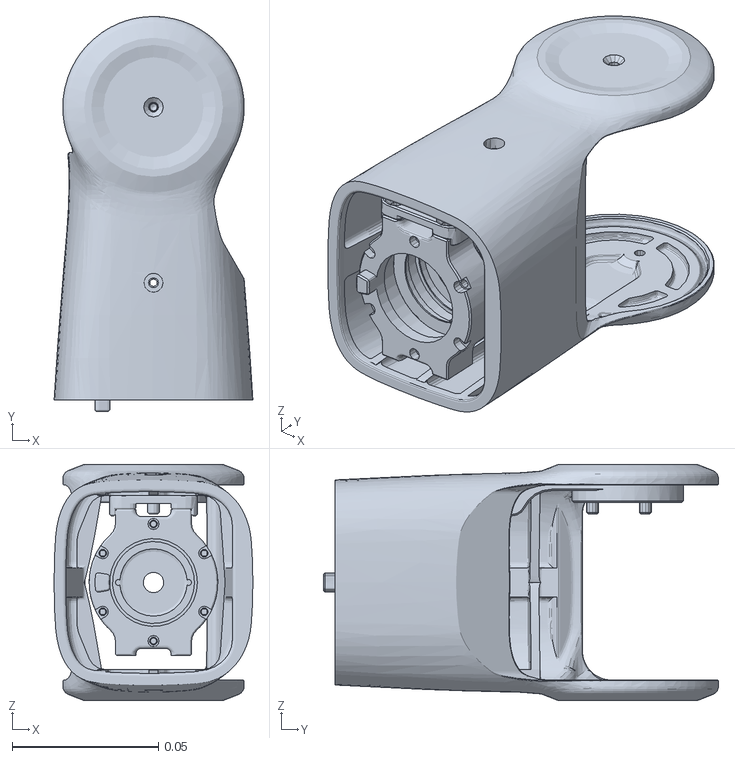
[picture p71: CAD file, 2026-10-11]
assets/vendor_files/agx_arm_urdf-main/nero/meshes/link4.stl
0.0679 x 0.135 x 0.0808
