MuX2001/cad-piper-paxini-adaptor/assets/vendor_files/agx_arm_urdf-main/piper/meshes/link1.stl

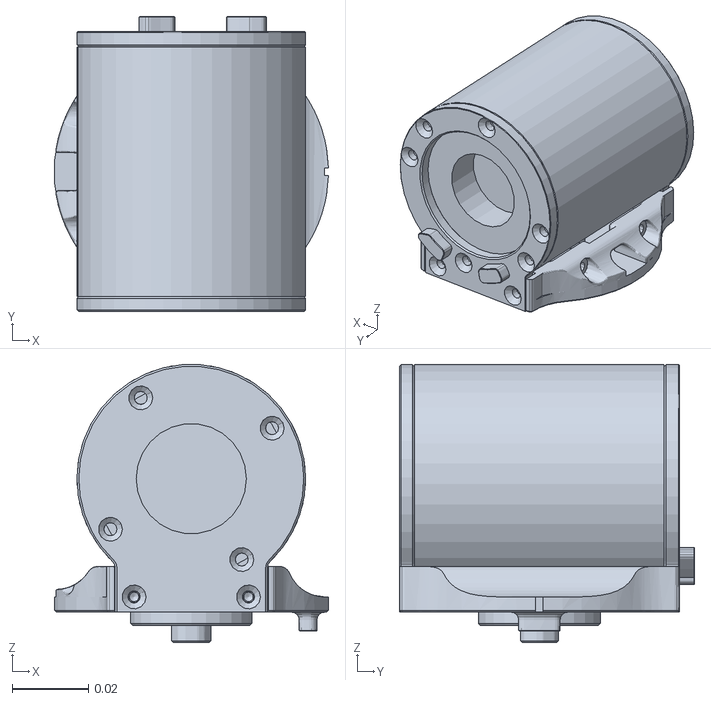
[picture p72: CAD file, 2026-10-11]
assets/vendor_files/agx_arm_urdf-main/piper/meshes/link1.stl
0.0719 x 0.0775 x 0.073
