MuX2001/cad-piper-paxini-adaptor/assets/vendor_files/agx_arm_urdf-main/revo2/meshes/revo2_left_hand/left_pinky_distal_link.STL

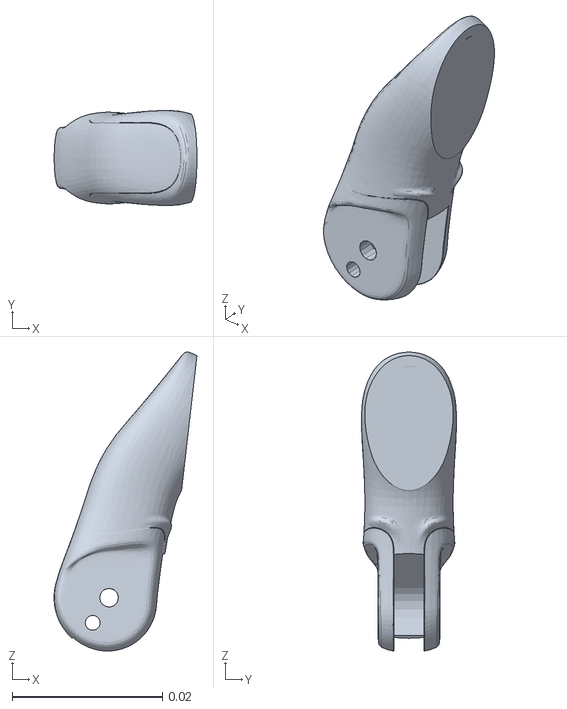
[picture p75: CAD file, 2026-10-11]
assets/vendor_files/agx_arm_urdf-main/revo2/meshes/revo2_left_hand/left_pinky_distal_link.STL
0.019 x 0.0127 x 0.0398
