MuX2001/cad-piper-paxini-adaptor/assets/vendor_files/agx_arm_urdf-main/revo2/meshes/revo2_right_hand/right_index_distal_link.STL

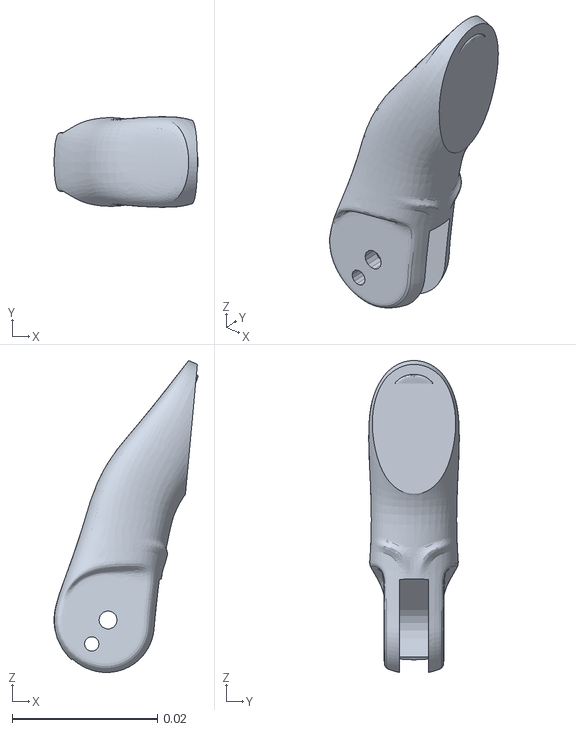
[picture p76: CAD file, 2026-10-11]
assets/vendor_files/agx_arm_urdf-main/revo2/meshes/revo2_right_hand/right_index_distal_link.STL
0.0198 x 0.0125 x 0.043
