MuX2001/cad-piper-paxini-adaptor/assets/vendor_files/GEN3触觉传感器3D模型/3D Models 3D图纸/Finger pad 指腹 M2324 PX6AX-GEN3-IP-M2324-Core PXSR-STDIP03A.stp

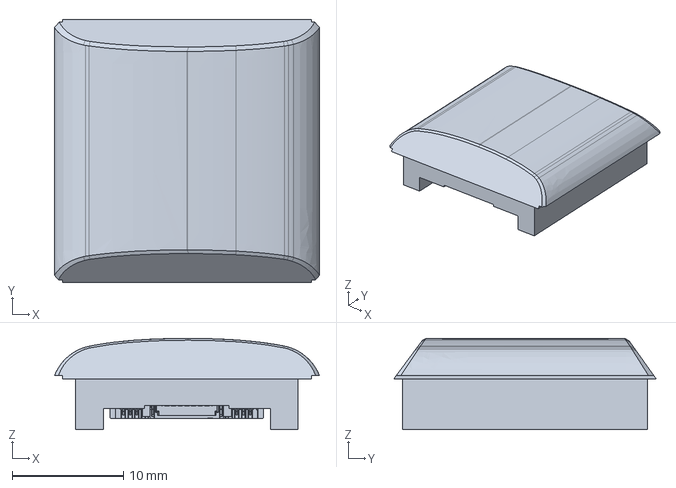
[picture p77: CAD file, 2026-10-11]
assets/vendor_files/GEN3触觉传感器3D模型/3D Models 3D图纸/Finger pad 指腹 M2324 PX6AX-GEN3-IP-M2324-Core PXSR-STDIP03A.stp
23.8 x 23.6 x 8.20 mm
