MuX2001/cad-piper-paxini-adaptor/assets/vendor_files/agx_arm_urdf-main/nero/meshes/link6.stl

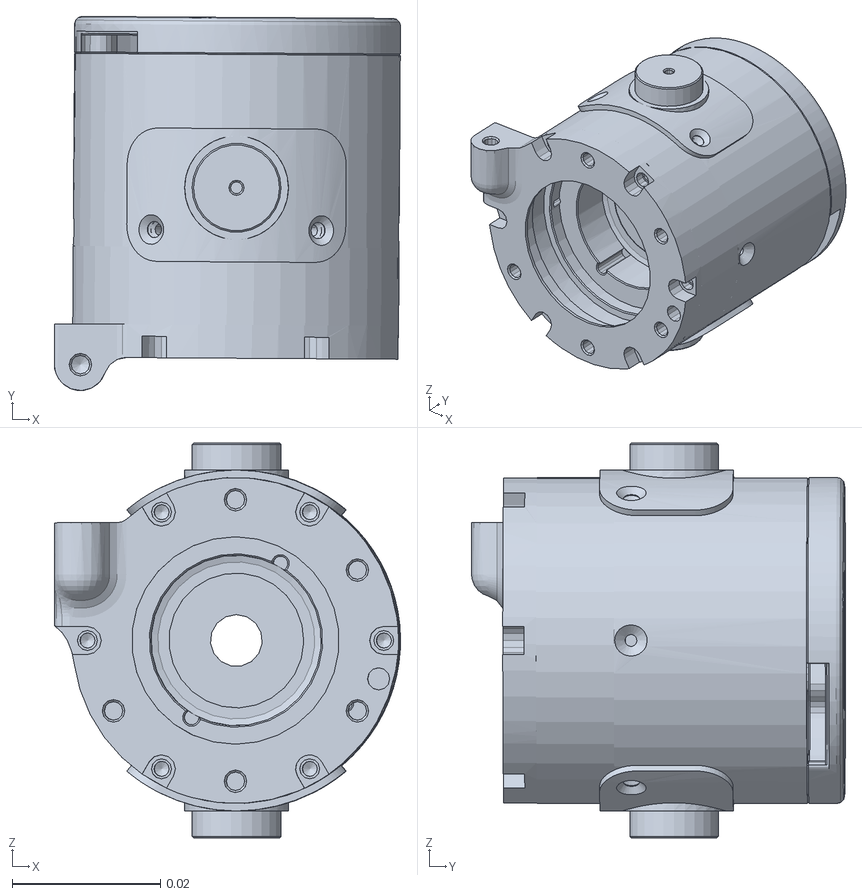
[picture p78: CAD file, 2026-10-11]
assets/vendor_files/agx_arm_urdf-main/nero/meshes/link6.stl
0.0467 x 0.0505 x 0.0533
