MuX2001/cad-piper-paxini-adaptor/assets/vendor_files/agx_arm_urdf-main/piper/meshes/link6.stl

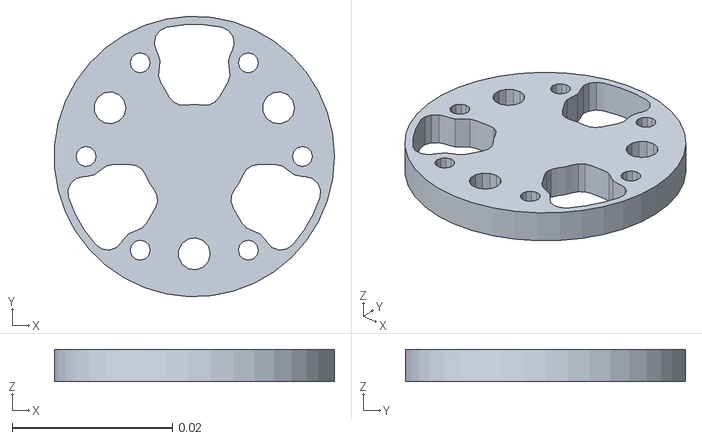
[picture p79: CAD file, 2026-10-11]
assets/vendor_files/agx_arm_urdf-main/piper/meshes/link6.stl
0.0349 x 0.035 x 0.004
