MuX2001/cad-piper-paxini-adaptor/assets/vendor_files/agx_arm_urdf-main/revo2/meshes/revo2_right_hand/right_index_touch_link.STL

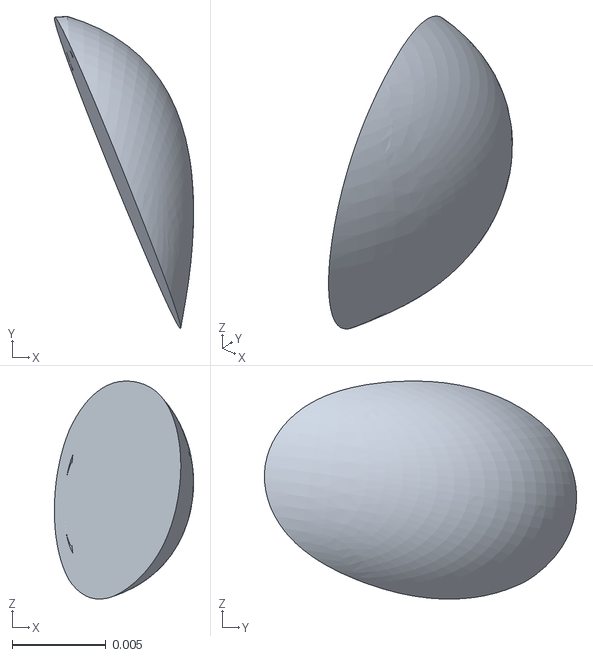
[picture p83: CAD file, 2026-10-11]
assets/vendor_files/agx_arm_urdf-main/revo2/meshes/revo2_right_hand/right_index_touch_link.STL
0.00742 x 0.0166 x 0.0116
