MuX2001/cad-piper-paxini-adaptor/assets/vendor_files/GEN3触觉传感器3D模型/3D Models 3D图纸/Palm 掌心 M2020 PX6AX-GEN3-MC-M2020-Elite PXSR-STDMC03A.STP

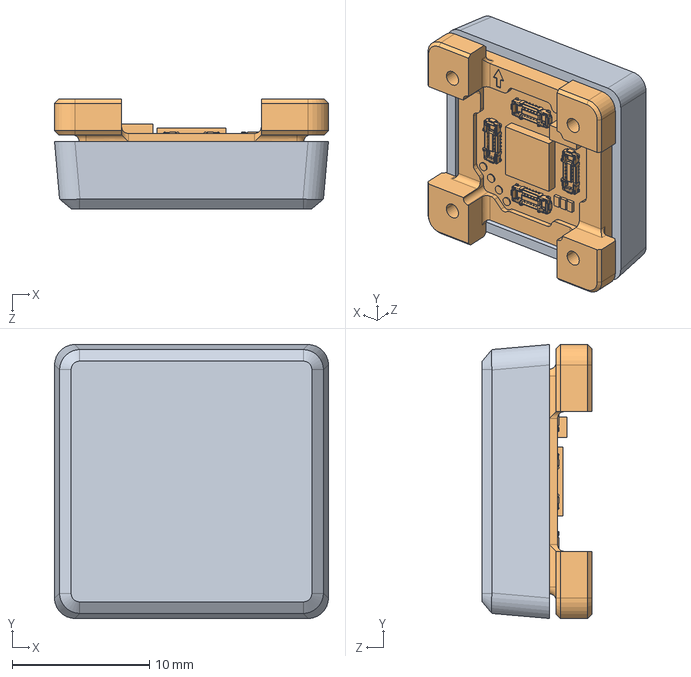
[picture p84: CAD file, 2026-10-11]
assets/vendor_files/GEN3触觉传感器3D模型/3D Models 3D图纸/Palm 掌心 M2020 PX6AX-GEN3-MC-M2020-Elite PXSR-STDMC03A.STP
20.0 x 20.0 x 8.00 mm
