MuX2001/cad-piper-paxini-adaptor/assets/vendor_files/agx_arm_urdf-main/nero/meshes/flange.stl

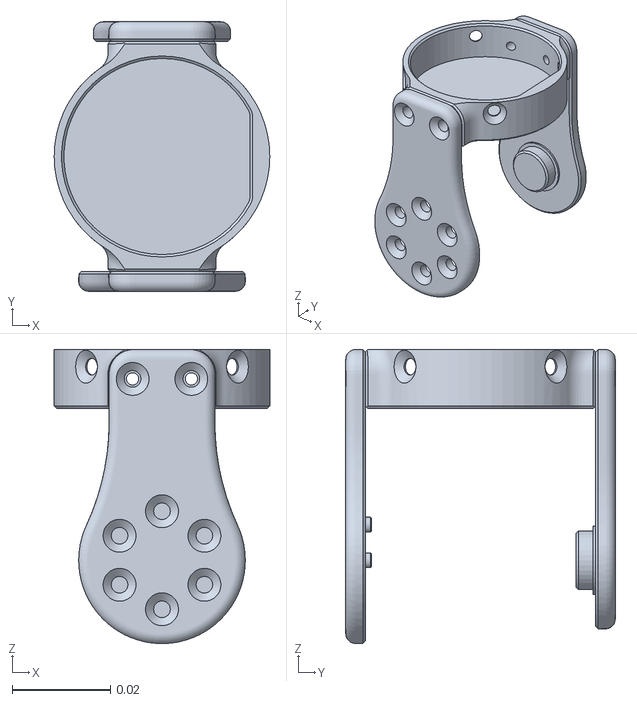
[picture p85: CAD file, 2026-10-11]
assets/vendor_files/agx_arm_urdf-main/nero/meshes/flange.stl
0.044 x 0.055 x 0.06
