MuX2001/cad-piper-paxini-adaptor/assets/vendor_files/GEN3触觉传感器3D模型/3D Models 3D图纸/Fingertip and pad 指尖指腹 PX6AX-GEN3-DP-S3013-Core PXSR-STDDP03E.stp

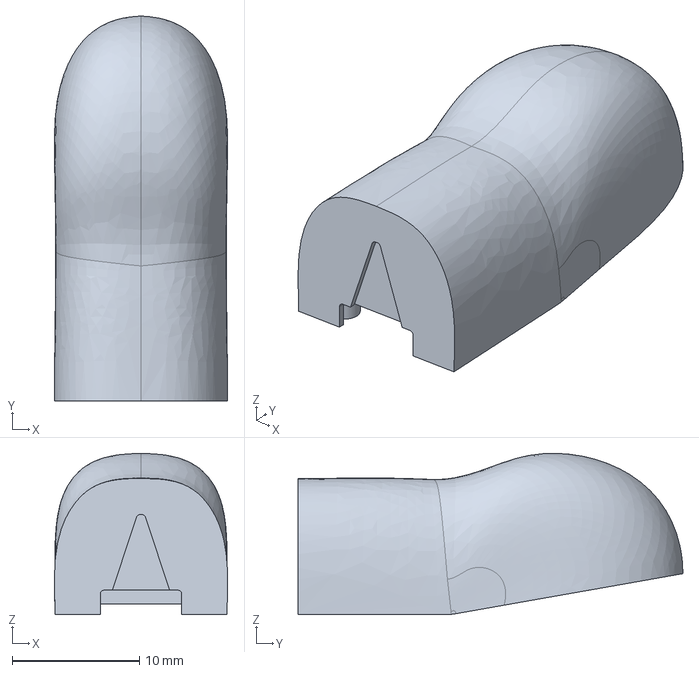
[picture p88: CAD file, 2026-10-11]
assets/vendor_files/GEN3触觉传感器3D模型/3D Models 3D图纸/Fingertip and pad 指尖指腹 PX6AX-GEN3-DP-S3013-Core PXSR-STDDP03E.stp
13.6 x 30.2 x 12.7 mm
