MuX2001/cad-piper-paxini-adaptor/cad/exported/piper_m2324-reference_outer_roof.step

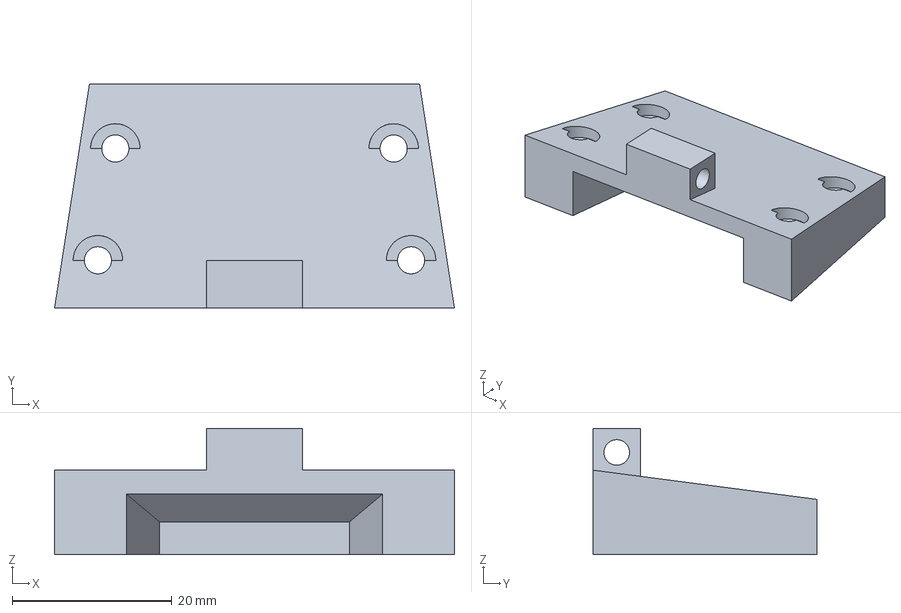
[picture p89: CAD file, 2026-10-11]
cad/exported/piper_m2324-reference_outer_roof.step
50.1 x 28.1 x 15.8 mm
