MuX2001/cad-piper-paxini-adaptor/assets/vendor_files/GEN3触觉传感器3D模型/3D Models 3D图纸/Finger pad 指腹 S1610 PX6AX-GEN3-IP-S1610-Elite PXSR-STDIP03B.stp

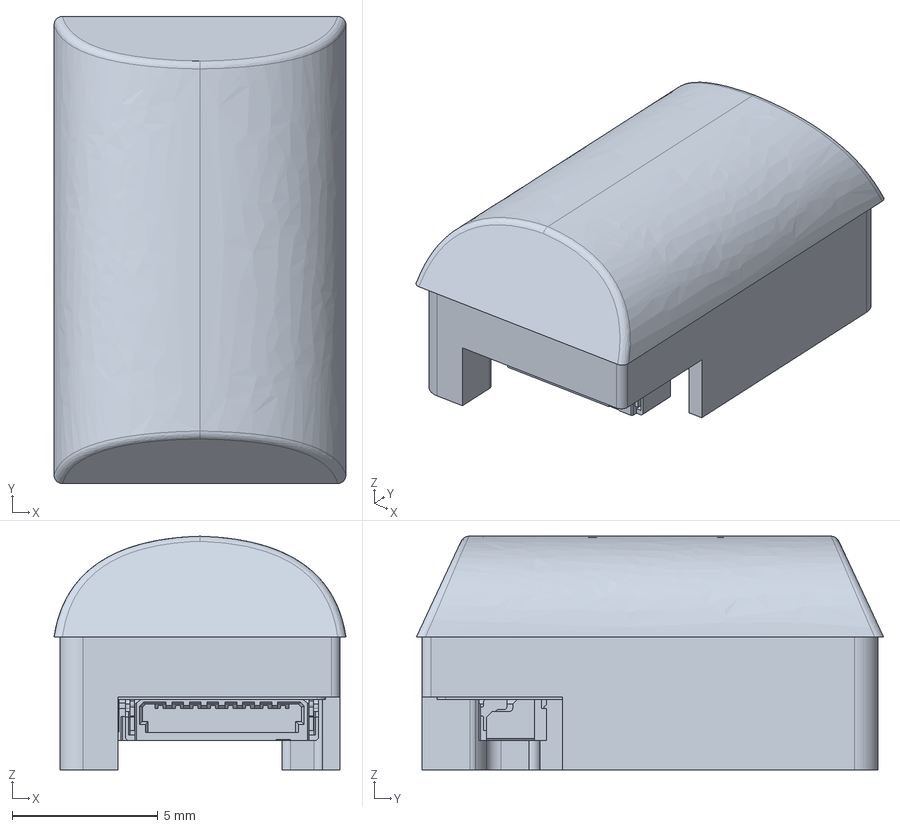
[picture p92: CAD file, 2026-10-11]
assets/vendor_files/GEN3触觉传感器3D模型/3D Models 3D图纸/Finger pad 指腹 S1610 PX6AX-GEN3-IP-S1610-Elite PXSR-STDIP03B.stp
10.0 x 16.0 x 8.00 mm
