MuX2001/cad-piper-paxini-adaptor/cad/exported/piper_finger_fit_gauge_roof.stl

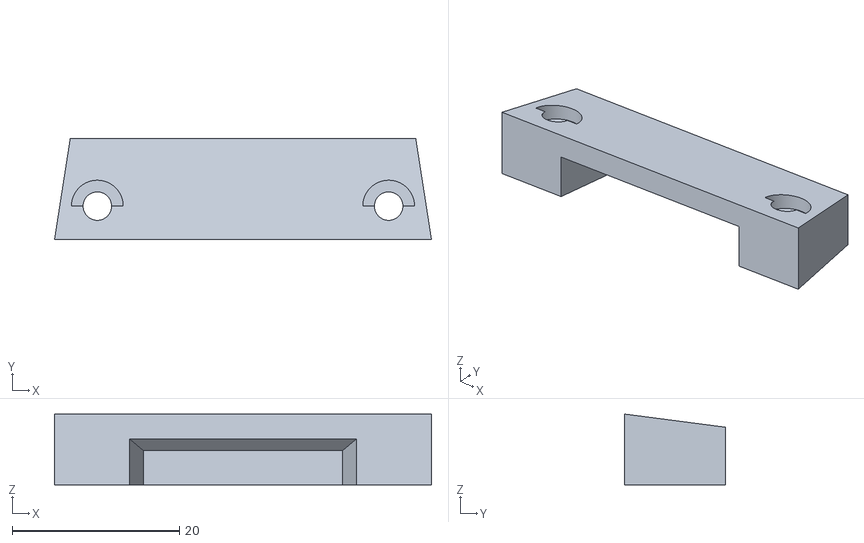
[picture p93: CAD file, 2026-10-11]
cad/exported/piper_finger_fit_gauge_roof.stl
45.1 x 12.1 x 8.48
