MuX2001/cad-piper-paxini-adaptor/v2/cad/exported/piper-gripper-paxini-adapter-v2.3mf

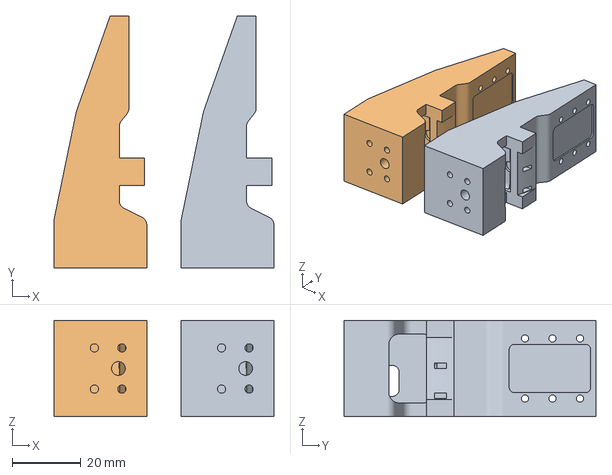
[picture p94: CAD file, 2026-10-16]
v2/cad/exported/piper-gripper-paxini-adapter-v2.3mf
64.0 x 73.2 x 28.0 mm
replacement_finger_print.stl x 2
