MuX2001/cad-piper-paxini-adaptor/assets/vendor_files/GEN3触觉传感器3D模型/3D Models 3D图纸/Finger pad 指腹 L5325 PX6AX-GEN3-CP-L5325-Omega PXSR-STDCP03A.stp

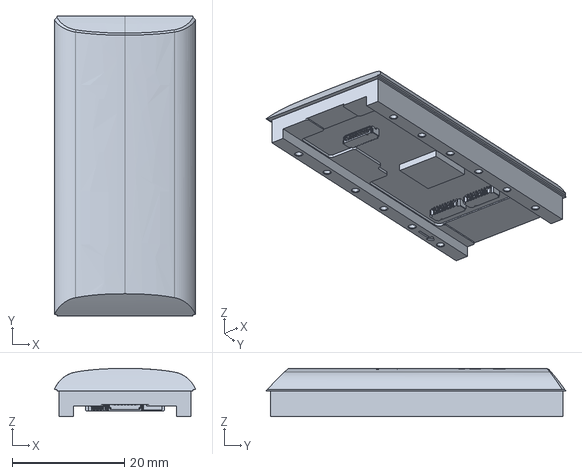
[picture p95: CAD file, 2026-10-11]
assets/vendor_files/GEN3触觉传感器3D模型/3D Models 3D图纸/Finger pad 指腹 L5325 PX6AX-GEN3-CP-L5325-Omega PXSR-STDCP03A.stp
25.1 x 53.4 x 8.57 mm
