MuX2001/cad-piper-paxini-adaptor/assets/vendor_files/GEN3触觉传感器3D模型/3D Models 3D图纸/Fingertip 指尖 13mm PX6AX-GEN3-DP-S1813-Core PXSR-STDDP03D.stp

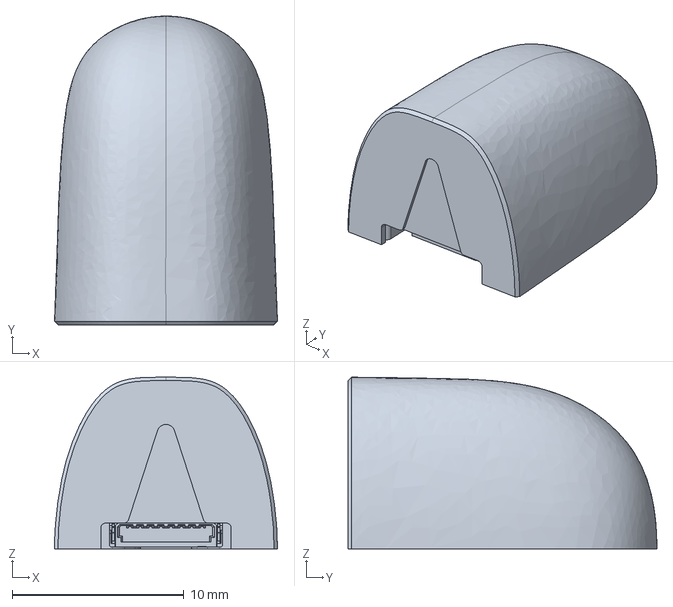
[picture p97: CAD file, 2026-10-11]
assets/vendor_files/GEN3触觉传感器3D模型/3D Models 3D图纸/Fingertip 指尖 13mm PX6AX-GEN3-DP-S1813-Core PXSR-STDDP03D.stp
13.0 x 18.0 x 10.00 mm
