MuX2001/cad-piper-paxini-adaptor/assets/vendor_files/agx_arm_urdf-main/revo2/meshes/revo2_right_hand/right_thumb_metacarpal_link.STL

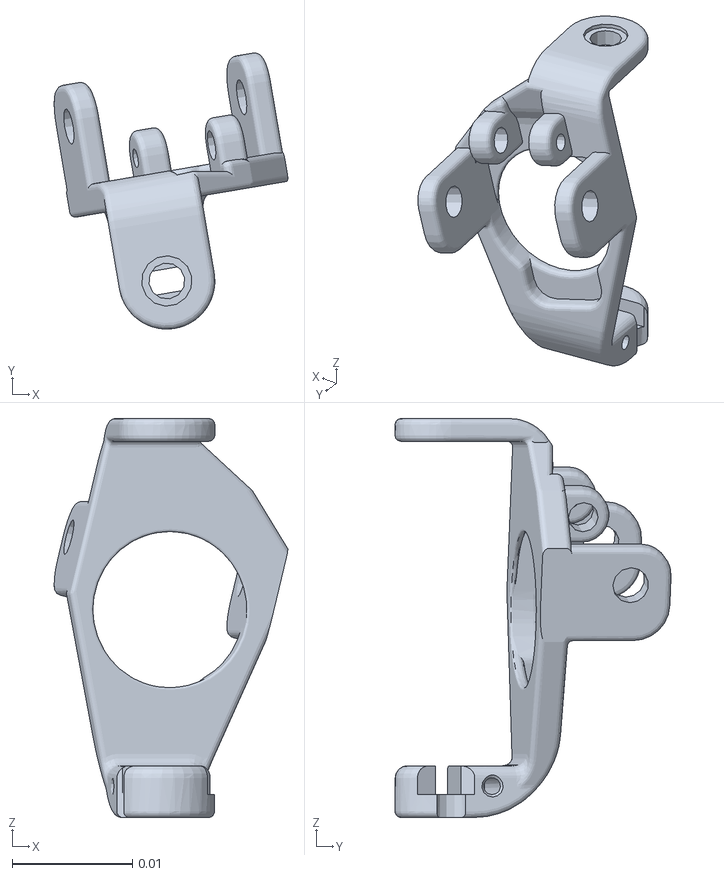
[picture p102: CAD file, 2026-10-11]
assets/vendor_files/agx_arm_urdf-main/revo2/meshes/revo2_right_hand/right_thumb_metacarpal_link.STL
0.0194 x 0.023 x 0.0332
