MuX2001/cad-piper-paxini-adaptor/(list of files, cad)

Other CAD files:
v2/revisions/before-geometry-simplification/cad/exported/replacement_finger_print.stl
assets/vendor_files/agx_arm_urdf-main/revo2/meshes/revo2_left_hand/left_ring_tip_link.STL
assets/vendor_files/agx_arm_urdf-main/revo2/meshes/revo2_right_hand/right_thumb_proximal_visual_link.STL
v2/revisions/before-geometry-simplification/cad/exported/fastener_coupon_print.stl
v2/revisions/before-printability-audit/cad/exported/fastener_coupon.step
assets/vendor_files/agx_arm_urdf-main/agx_gripper/meshes/gripper_link2.stl
v2/cad/exported/replacement_finger.step
v2/revisions/before-geometry-simplification/cad/exported/cable_routing_open50.step
v2/revisions/before-printability-audit/cad/exported/replacement_finger.step
assets/vendor_files/agx_arm_urdf-main/revo2/meshes/revo2_right_hand/right_pinky_proximal_link.STL
cad/exported/piper_m2324-v2_fit_gauge_inner_print.stl
v2/cad/exported/fastener_coupon.step
v2/revisions/before-geometry-simplification/cad/exported/fastener_coupon.step
v2/revisions/before-printability-audit/cad/exported/replacement_finger_print.stl
v2/revisions/before-shallow-counterbores/cad/exported/replacement_finger.step
v2/revisions/before-short-sensor-pads/cad/exported/replacement_finger.step
v2/cad/exported/mount_fit_gauge.step
v2/revisions/before-shallow-counterbores/cad/exported/replacement_finger_print.stl
v2/revisions/before-short-sensor-pads/cad/exported/mount_fit_gauge.step
assets/vendor_files/agx_arm_urdf-main/revo2/meshes/revo2_left_hand/left_thumb_distal_link.STL
assets/vendor_files/agx_arm_urdf-main/revo2/meshes/revo2_right_hand/right_pinky_touch_link.STL
v2/revisions/before-geometry-simplification/cad/exported/mount_fit_gauge.step
v2/revisions/goal-02/cad/exported/cable_routing_open50.step
assets/vendor_files/agx_arm_urdf-main/piper_h/meshes/link6.stl
cad/exported/piper_m2324-v2_fit_gauge_roof.step
v2/revisions/before-short-sensor-pads/cad/exported/fastener_coupon.step
v2/revisions/goal-02/cad/exported/replacement_finger.step
assets/vendor_files/agx_arm_urdf-main/revo2/meshes/revo2_left_hand/left_index_tip_link.STL
cad/exported/piper_m2324-reference_inner_plate.step
v2/revisions/before-geometry-simplification/cad/exported/finger_sensor_pair_open50.step
v2/revisions/before-shallow-counterbores/cad/exported/cable_routing_open50.step
v2/revisions/before-short-sensor-pads/cad/exported/fastener_coupon_print.stl
v2/revisions/goal-02/cad/exported/fastener_coupon.step
v2/cad/exported/fastener_coupon_print.stl
v2/revisions/before-geometry-simplification/cad/exported/replacement_finger.step
v2/revisions/before-shallow-counterbores/cad/exported/fastener_coupon.step
v2/revisions/before-short-sensor-pads/cad/exported/cable_routing_open50.step
assets/vendor_files/agx_arm_urdf-main/revo2/meshes/revo2_left_hand/left_index_proximal_link.STL
assets/vendor_files/agx_arm_urdf-main/revo2/meshes/revo2_right_hand/right_thumb_tip.STL
assets/vendor_files/agx_arm_urdf-main/revo2/meshes/revo2_right_hand/right_index_tip.STL
assets/vendor_files/agx_arm_urdf-main/revo2/meshes/revo2_left_hand/left_index_distal_link.STL
assets/vendor_files/agx_arm_urdf-main/revo2/meshes/revo2_right_hand/right_middle_tip.STL
assets/vendor_files/agx_arm_urdf-main/revo2/meshes/revo2_right_hand/right_middle_touch_link.STL
assets/vendor_files/agx_arm_urdf-main/revo2/meshes/revo2_left_hand/left_middle_tip_link.STL
assets/vendor_files/agx_arm_urdf-main/revo2/meshes/revo2_left_hand/left_pinky_tip_link.STL
assets/vendor_files/agx_arm_urdf-main/revo2/meshes/revo2_left_hand/left_thumb_tip_link.STL
assets/vendor_files/agx_arm_urdf-main/revo2/meshes/revo2_right_hand/right_pinky_distal_link.STL
assets/vendor_files/agx_arm_urdf-main/revo2/meshes/revo2_left_hand/left_ring_touch_link.STL
assets/vendor_files/agx_arm_urdf-main/revo2/meshes/revo2_right_hand/right_ring_tip.STL
assets/vendor_files/agx_arm_urdf-main/revo2/meshes/revo2_left_hand/left_base_link.STL
assets/vendor_files/agx_arm_urdf-main/revo2/meshes/revo2_left_hand/left_middle_proximal_link.STL
assets/vendor_files/agx_arm_urdf-main/revo2/meshes/revo2_left_hand/left_ring_proximal_link.STL
assets/vendor_files/agx_arm_urdf-main/revo2/meshes/revo2_left_hand/left_thumb_metacarpal_link.STL
assets/vendor_files/agx_arm_urdf-main/revo2/meshes/revo2_right_hand/right_base_link.STL
assets/vendor_files/agx_arm_urdf-main/revo2/meshes/revo2_right_hand/right_middle_distal_link.STL
assets/vendor_files/agx_arm_urdf-main/revo2/meshes/revo2_right_hand/right_ring_distal_link.STL
assets/vendor_files/agx_arm_urdf-main/revo2/meshes/revo2_right_hand/right_ring_proximal_link.STL
assets/vendor_files/agx_arm_urdf-main/revo2/meshes/revo2_right_hand/right_thumb_proximal_link.STL
cad/exported/piper_m2324-reference_outer_roof.stl
cad/exported/piper_m2324-v2_fastener_coupon.stl
cad/exported/piper_m2324-v2_fit_gauge_inner.stl
cad/exported/piper_m2324-v2_fit_gauge_roof.stl
cad/exported/piper_m2324-v2_inner_plate.stl
cad/exported/piper_m2324-v2_outer_roof.stl
v2/cad/exported/fastener_coupon.stl
v2/cad/exported/mount_fit_gauge.stl
v2/cad/exported/replacement_finger.stl
v2/cad/exported/sensor_screw_access.step
v2/revisions/before-geometry-simplification/cad/exported/fastener_coupon.stl
v2/revisions/before-geometry-simplification/cad/exported/mount_fit_gauge.stl
v2/revisions/before-geometry-simplification/cad/exported/replacement_finger.stl
v2/revisions/before-geometry-simplification/cad/exported/sensor_screw_access.step
v2/revisions/before-printability-audit/cad/exported/replacement_finger.stl
v2/revisions/before-shallow-counterbores/cad/exported/mount_fit_gauge.stl
v2/revisions/before-shallow-counterbores/cad/exported/replacement_finger.stl
v2/revisions/before-shallow-counterbores/cad/exported/sensor_screw_access.step
v2/revisions/before-short-sensor-pads/cad/exported/fastener_coupon.stl
v2/revisions/before-short-sensor-pads/cad/exported/mount_fit_gauge.stl
v2/revisions/before-short-sensor-pads/cad/exported/replacement_finger.stl
v2/revisions/before-short-sensor-pads/cad/exported/sensor_screw_access.step
v2/revisions/goal-02/cad/exported/mount_fit_gauge.stl
v2/revisions/goal-02/cad/exported/replacement_finger.stl
