MuX2001/cad-piper-paxini-adaptor/drawings/screenshots/piper_dual_m2324-v2_assembly.png

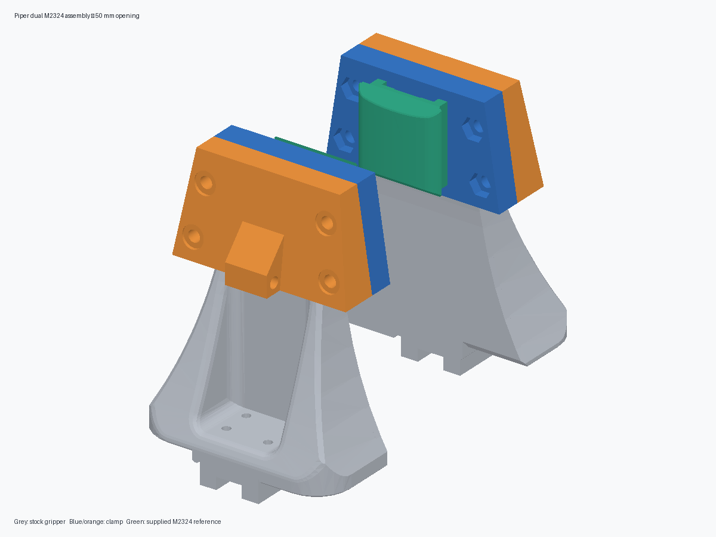
drawings/screenshots/piper_dual_m2324-v2_assembly.png
