MuX2001/cad-piper-paxini-adaptor/drawings/screenshots/piper_m2324-reference_assembly.png

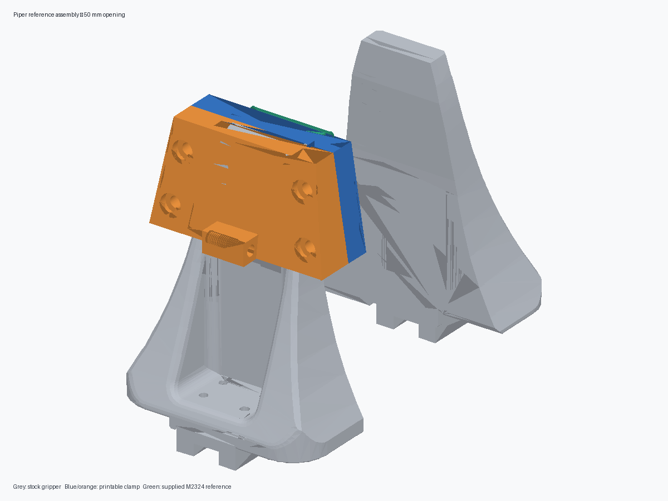
drawings/screenshots/piper_m2324-reference_assembly.png
