MuX2001/cad-piper-paxini-adaptor/v2/drawings/assembly.png

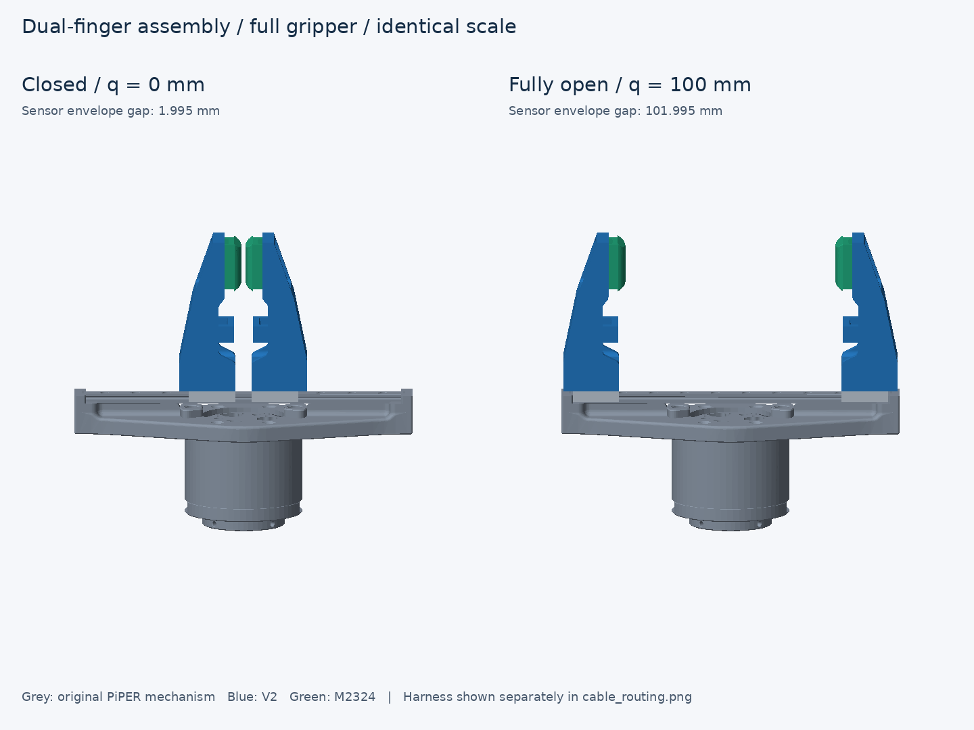
v2/drawings/assembly.png
