MuX2001/cad-piper-paxini-adaptor/v2/drawings/print_orientation.png

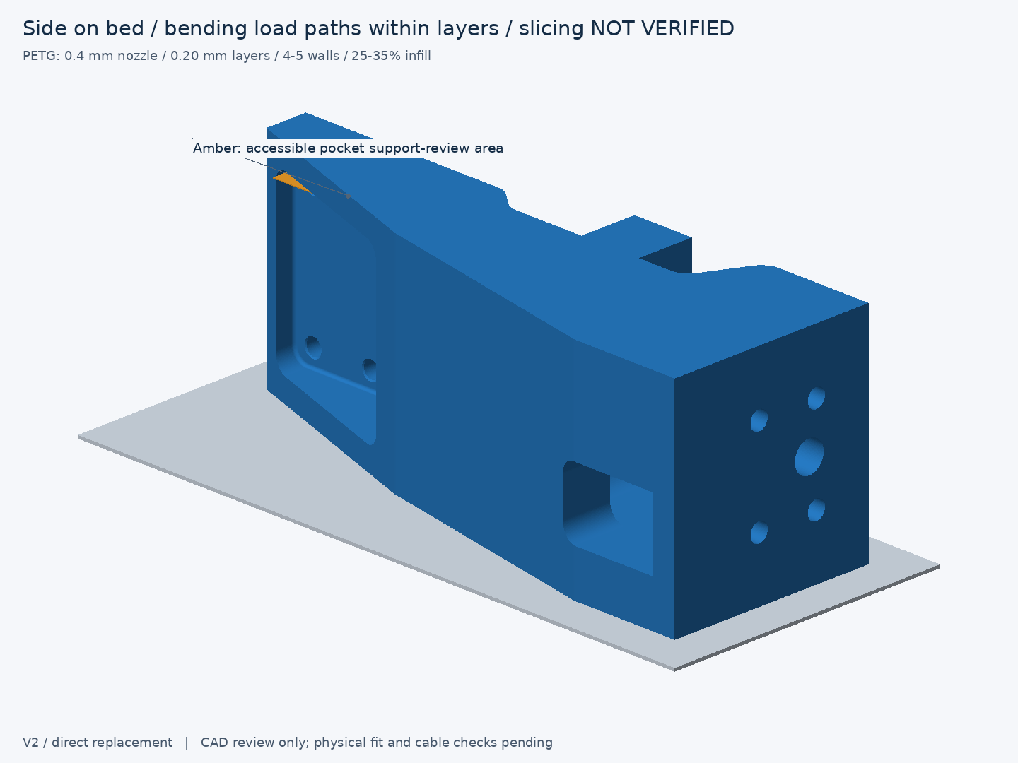
v2/drawings/print_orientation.png
