MuX2001/cad-piper-paxini-adaptor/v2/revisions/before-geometry-simplification/drawings/assembly_open0.png

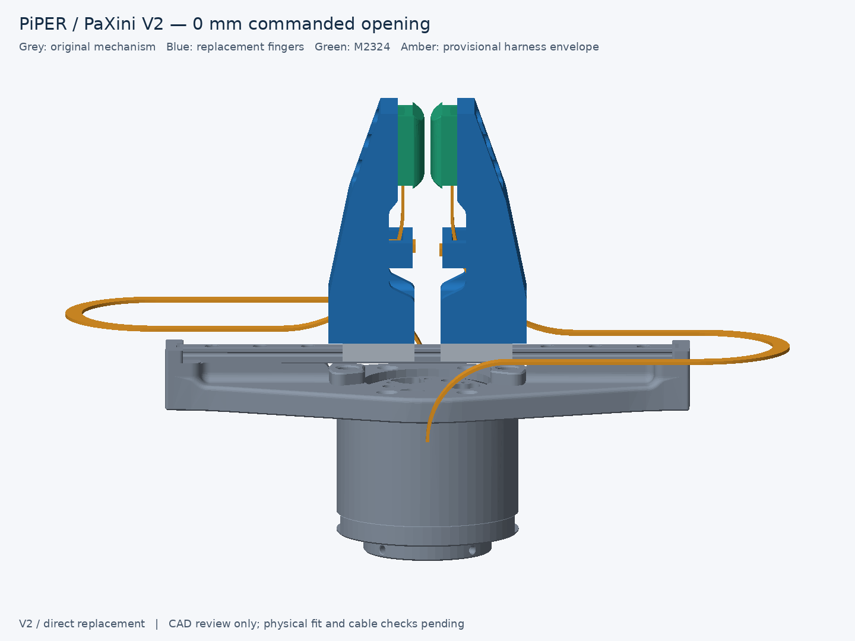
v2/revisions/before-geometry-simplification/drawings/assembly_open0.png
