MuX2001/cad-piper-paxini-adaptor/v2/revisions/before-geometry-simplification/drawings/print_orientation.png

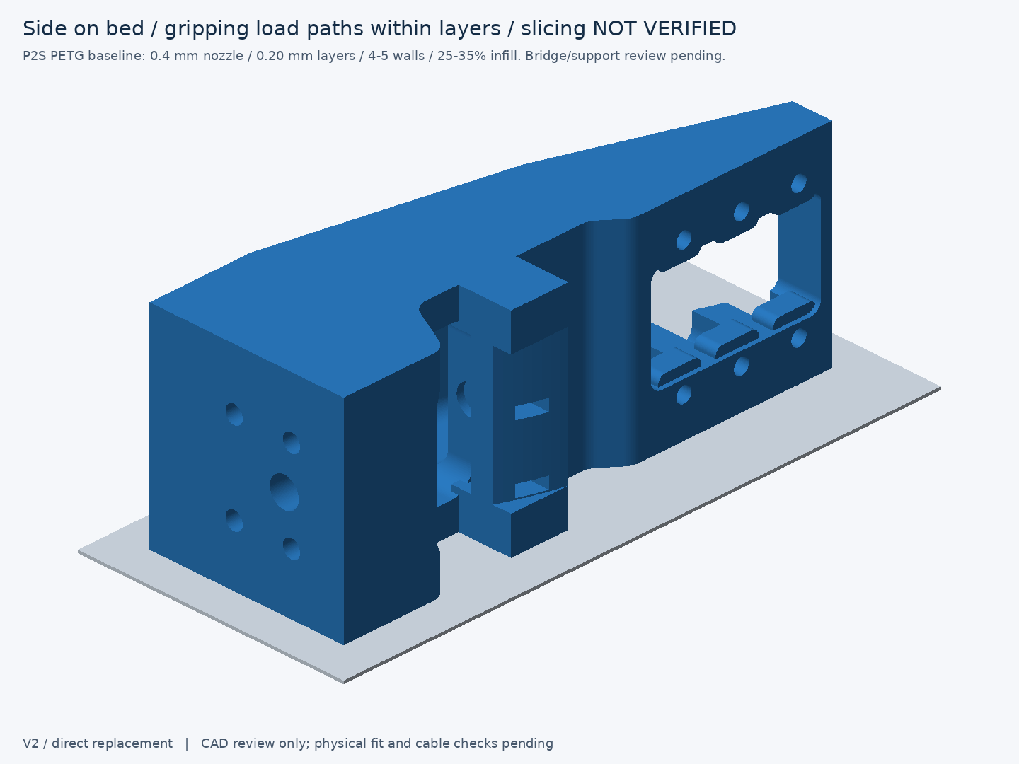
v2/revisions/before-geometry-simplification/drawings/print_orientation.png
