MuX2001/cad-piper-paxini-adaptor/v2/revisions/before-geometry-simplification/drawings/sensor_screw_access_assembly.png

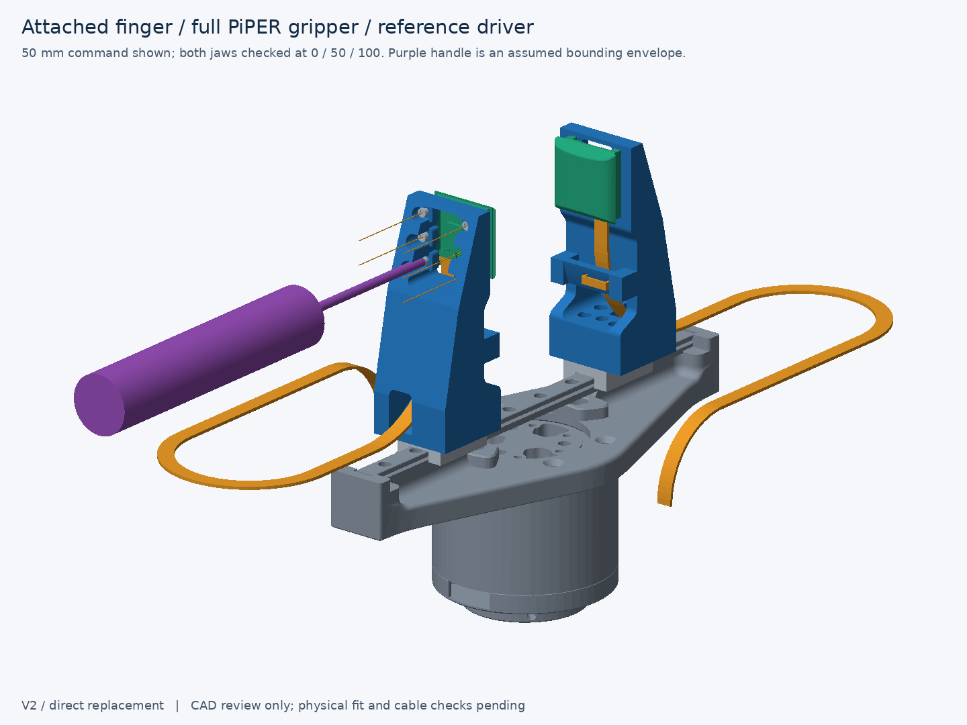
v2/revisions/before-geometry-simplification/drawings/sensor_screw_access_assembly.png
