MuX2001/cad-piper-paxini-adaptor/v2/revisions/goal-02/drawings/print_orientation.png

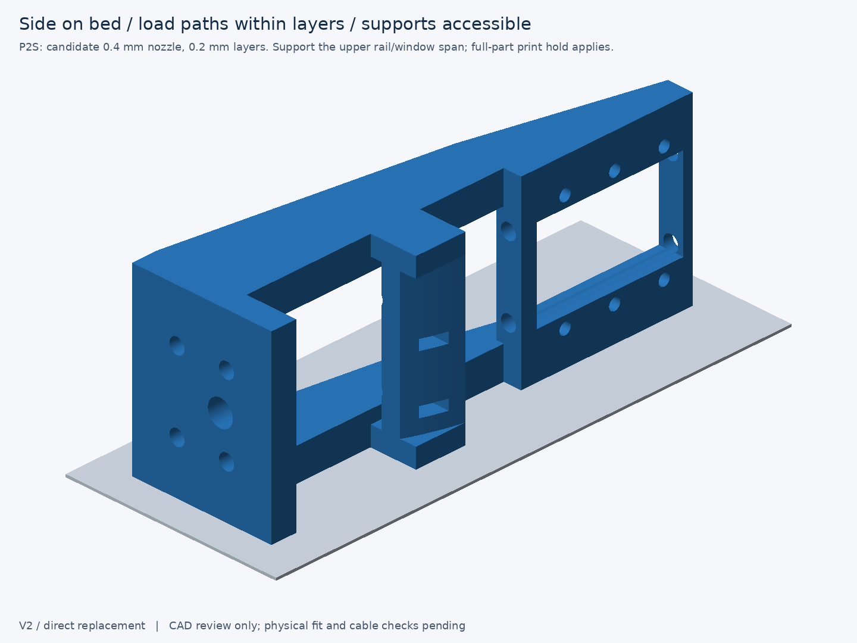
v2/revisions/goal-02/drawings/print_orientation.png
