MuX2001/cad-piper-paxini-adaptor/measurements/m2324-v2-fit-results.md

# M2324-v2 physical results — pending

Record actual data, not CAD values; include date, operator, instrument and uncertainty. Label photos by finger/sensor and include a scale. No tests have been reported.

| Reproduction field | Actual value |
| --- | --- |
| Source revision / file hashes; profile | Pending; use m2324-v2 and validation input hashes |
| STL names and SHA-256 | Pending |
| Import unit / scale | Pending; required mm / 100% |
| Printer, slicer/version, nozzle, layer, perimeters, infill | Pending |
| Material / batch, temperatures, cooling | Pending |
| Orientation, brim, supports, postprocessing | Pending |
| Date / instrument / uncertainty | Pending |

| Finger | Local Y mm | Width mm | Thickness mm | Surface/coating |
| --- | ---: | --- | --- | --- |
| 1 | −25 | Pending | Pending | Pending |
| 1 | −15 | Pending | Pending | Pending |
| 1 | −2 | Pending | Pending | Pending |
| 2 | −25 | Pending | Pending | Pending |
| 2 | −15 | Pending | Pending | Pending |
| 2 | −2 | Pending | Pending | Pending |

| Trial | Finger 1 | Finger 2 |
| --- | --- | --- |
| Bare inner gauge tightness / gaps | Pending | Pending |
| Bare roof gauge tightness / gaps | Pending | Pending |
| Paired gauge stop / bolt alignment | Pending | Pending |
| Upper / lower liner thickness, material, compression | Pending | Pending |
| Total interference / remaining side gaps | Pending | Pending |

For each coupon lane (0.00 / +0.10 / +0.20), record measured M1.6 bore/head, M3 bore/head, nut across-flats/depth, real fastener dimensions and fits. Also record horizontal M3/head fits in the roof gauge. All results: **pending**.

For each sensor: label, mounting-back, plug/cable photos; intended IN/OUT port; connector envelope; minimum inserted-cable bending space; service loop and full-travel route: **pending**.

No final liner choice, compensation, minimum opening or full-print release follows automatically. Return data and resume the Goal for review.
