MuX2001/cad-piper-paxini-adaptor/v2/revisions/before-geometry-simplification/docs/validation-report.md

# Reinforced V2 — short sensor mounting flanges — 2026-10-16

**The screw-head seats have moved down to Z=12.8, giving a 3.6 mm effective pass-through at all six locations.** The sensor plane remains Z=9.2. The previous proximal passage was 14.6 mm at seat Z= 23.8; this is an actual 11.0 mm seat movement, not a change in counterbore depth. Six tall cylindrical bosses are removed, replaced by short rounded flanges and inward-opening U pockets. Every location uses the same M1.6×5 reference screw.

The normal `v2/scripts/cad/build_v2.py` build and validator include both original V1 validators and the PETG acceptance audit. [Machine results](validation.json) are tied to [source/export hashes](build-manifest.json). The build regenerates 17 CAD/mesh exports, 24 PNGs and the analysis records. The real archived/current solids are shown at the same scale in the [old/new section](../drawings/sensor_screw_seating.png). The [PETG / P2S acceptance table](printability-acceptance.md) is authoritative for printability status: **CAD VALIDATED for reference geometry, slicing NOT VERIFIED, not print-ready**.

| Check | Result and limits |
| --- | --- |
| Actual screw passage | **S1–S6: 3.6 mm** from flat head seat to sensor mounting plane. Previous row stacks 6.6 /10.6 /14.6 mm are removed. Candidate screws are all 5 mm long. |
| Short flange support | Six 6 × 6 mm flanges; minimum inner lip thickness 3.0 mm. Ø2.1 bores retain 0.15 ×45° relief. Minimum bore-edge ligament 1.95 mm; nominal head-edge distance 1.50 mm. The minimum ISO bearing annulus is fully supported. |
| Open access | Six 4.5 mm wide U pockets open directly into the sensor window, with R 0.4 floor transitions. Every head-width lateral corridor has zero overlap. There are no enclosed cylindrical tool tunnels or counterbores at these seats. |
| Per-screw assembly | **S1 PASS; S2 PASS; S3 PASS; S4 PASS; S5 PASS; S6 PASS** for reference insertion, seating, tightening and removal. Both attached jaw assemblies are checked against finger, sensor housing, original moving blocks, other screws, harness and complete actuator envelope. |
| Minimum clearance | Screw-to-finger free surface 0.1414 mm, excluding intended bearing/thread contact. Driver radial clearance 0.75 mm. With 0.30 mm diametric hole/pocket undersize, all sweeps still clear and driver clearance remains 0.60 mm. |
| Thread engagement | Manufacturer specifies M1.6 tapped holes, depth 2 mm. Nominal penetration 1.4 mm and depth margin 0.6 mm. Screw-length tolerance plus assumed ±0.15 mm printed-stack error gives 1.01–1.79 mm penetration, leaving 0.21 mm minimum to nominal depth. Actual usable threads and allowable torque remain unverified. |
| Reinforcement retained | Root collar, 6 mm root seats, 5 mm main webs and outer geometry are preserved. The printability audit found a rear skin of 3.428 mm normal thickness; a 0.073738 mm inward core-roof correction now gives 3.500 mm. Exact booleans confine that addition to the existing roof and its R2 transitions, with zero material removal. Original 3 mm outer sensor rails and 3.5 mm inter-pocket ligaments remain. |
| Local material change | Sensor-interface alteration against the rejected long passages: 1279.301 mm³ removed, 7.899 mm³ added. The subsequent normal-skin correction adds 40.319 mm³. Current finger volume is 22245.073 mm³; one valid connected solid. No removable mounting plate was needed. |
| Geometry preservation | Sensor pose,17.5 × 8 mm mounting pattern,70.000 mm functional reach, cable routing and all PiPER mounting interfaces match the existing design. The 12 mm sensor-removal sweep remains clear. |
| Motion and cable checks | Continuous pure-translation separation covers commands 0–100. Opposed sensor-envelope gap remains command + 1.994608484 mm. Five configurations check service loops;101 commands verify constant cable length. The inherited plug-box/vendor-housing withdrawal uncertainty is unchanged. |
| Export integrity | Finger, coupon and root gauge reimport as valid single STEP solids. All six native/print STLs receive explicit manifold, vertex-link, degenerate-face and triangle self-intersection checks. Exact results and hashes are in [printability acceptance](printability-acceptance.json). Envelope remains 27 × 73.2 × 28 mm. Normal assemblies retain 35 components, including the original actuator and retained blocks. |
| Preservation | V1 and all 232 original files plus both user inputs remain unchanged. The 47-file earlier V2 and 67-file reinforcement snapshots remain intact. The rejected long-passage V2 is preserved as 68 files in [before-short-sensor-pads](../revisions/before-short-sensor-pads), checked against [its manifest](pre-short-pad-revision.json). |

The existing beam comparison is regenerated for the current solid. It remains a geometric comparison under fully solid material assumptions, not a stiffness or filament-use prediction for the user's 4–5 walls / 25–35% infill baseline. It excludes local stress concentrations, joint compliance, FDM defects and sensor flexibility and does not certify flange strength, creep, torque or fatigue. See [mechanical comparison](mechanical-comparison.md).

The immediate preceding short-pad source and affected finger/coupon exports are retained as eight files in [the pre-audit geometry snapshot](pre-printability-revision.json). Coupon identification lands now measure 1.6 mm rather than 1.0 mm; its fit-hole axes, diameters and 3.6 mm thickness remain unchanged. The measured interface-specific thickness exceptions, including the 4 mm service walls and 1.5 mm distal sensor-window rim, are documented in the acceptance report.

**Actual hardware status is UNVERIFIED for S1, S2, S3, S4, S5 and S6.** No real screw/tool measurements were supplied. The catalog screw has Ø3 × 1.6 head and 1.5 mm hex; the driver reference has Ø3 shaft and 60 mm blade with 0.7 mm modeled socket engagement. The handle diameter is assumed. Actual PETG error, tip geometry, usable threads and tightening torque need physical confirmation. A 6 mm screw must not be substituted in this 3.6 mm stack.

Deliverables: [STEP](../cad/exported/replacement_finger.step), [print STL](../cad/exported/replacement_finger_print.stl), [14.6 versus 3.6 mm cross-section](../drawings/sensor_screw_seating.png), [six open paths](../drawings/sensor_screw_access.png), [complete access GLB](../cad/exported/sensor_screw_access.glb), [local access STEP](../cad/exported/sensor_screw_access.step), [per-screw report](sensor-screw-access.md). The existing coupon now represents the actual 3.6 mm pass-through.

No slicing, physical print/load test or powered gripper command was performed. The existing [PRINT-HOLD](../../PRINT-HOLD.md) and [physical checklist](../measurements/fit-checklist.md) remain in force. No new milestone, separate variant or unrelated mechanical change was introduced.
