MuX2001/cad-piper-paxini-adaptor/v2/revisions/before-shallow-counterbores/docs/validation-report.md

# Reinforced V2 mechanical and geometry audit — 2026-10-16

Goal-03 modifies the actual V2 solid with a deeper radiused root, 5 mm webs, 3.5 mm skins forming a partial box, and reinforced sensor screw surrounds. The original 70 mm reach, mounting axes, sensor pose and cable route are retained. V1 and original vendor assets remain unchanged; the complete previous V2 is archived for comparison.

Final `v2/scripts/cad/build_v2.py` regeneration and validation completed with **exit code 0**, including both original clamp validators. [Machine evidence](validation.json) is tied to [source/export hashes](build-manifest.json). The build produced **17 CAD/mesh exports, 23 PNG previews and five mechanical/access-analysis files**. The previews were visually reviewed. The main STL volume differs from its solid by **0.0119%**. See [regeneration commands](../README.md).

| Goal requirement | Evidence and limits |
| --- | --- |
| Preserve V1 and previous V2 | All 232 original file hashes and goals 02/03 match. All 47 snapshot files match both their recorded hashes and commit `fe94d0548cd070a5a3ab135652aff9194e426492`. Changes remain inside V2; no V3 or robot-control code. |
| Reinforce actual CAD | Width × length × depth is 28 × 73.2 × 27 mm. Main webs increase 3→5 mm, root bearing seat 4→6 mm, sensor rails 4→5.5 mm. Added 3.5 mm skins, Ø6 bosses and R2/R2.5/R3 transitions/openings are present in the B-rep. Volume is 22,486.374 mm³ after the six local sensor-seat chamfers. |
| Preserve root and sensor interfaces | Original four-hole 12 × 8 pattern matches both retained carriers. All six sensor axes and Z=9.2 seating plane match the supplied STEP. Tactile reach remains 70.000 mm; opposing normals remain base +Y/−Y. |
| Improve section geometry | Actual Y=−35 section changes from two open rails to one closed cell. Ixx increases 567→6,726 mm⁴; Izz increases 10,289→23,359 mm⁴. Root and sensor-region sections are also measured, including holes. |
| Evaluate gripping bending | Matched ideal-beam stiffness increases 20.8→185.3 N/mm, or 8.93×. Estimated deflection at representative 25 N decreases 1.2043→0.1349 mm; root-region nominal stress decreases 7.45→1.30 MPa. These exclude local stress concentrations and joint compliance. |
| Evaluate lateral/torsional risks | Coupled-section 10 N lateral deflection decreases 0.0422→0.0190 mm. Independent-face sensitivity is reported separately. The closed cell improves the shear-flow path, but root/sensor openings, FDM bonding and warping remain risks. No numerical whole-part torsion or fatigue rating is claimed. |
| Evaluate mass/material | Solid-equivalent mass increases 11.17→28.78 g per finger at reference density 1.28 g/cm³. E=1810 MPa is a PETG HF reference, not the actual print modulus. Actual material, infill/toolpaths, creep and cyclic strength remain unverified. |
| Check calculation consistency | Exact B-rep area properties pass an analytical rectangle check. 1/0.5 mm integration differs by at most 2.73% across the reported beam assumptions; integrated section volume differs from solid volume by at most 0.12%. Five current section samples are remeasured by validation. |
| Root load transfer and access | Complete head-bearing annuli remain through the 6 mm seat. Candidate M2×8 retains 2 mm nominal penetration. All four Ø3.8 head-insertion paths and short L-key poses at 0–60° in 5° steps clear the holder. Install roots before sensors/harness; actual threads, drive size, preload and bearing strength are unverified. |
| Sensor mounting and service | Existing screw seats remain at Z=11.8; M1.6×4 penetration remains 1.4 mm. Six bearing annuli, including their 0.15 mm bore-mouth reliefs, and rear tool paths pass. The complete conservative sensor envelope can move 12 mm toward the gap without catching the holder. Added bosses do not contact central electronics. |
| Connector and strain relief | Parallel DF53 orientation, 12 mm straight run and R38 bend remain unchanged. Plug, moving leads, releasable tie and screw envelopes clear the holder. The accessible saddle stays outside the closed cell. Holder/hardware clear the 8 mm straight unplug corridor; the inherited vendor-housing uncertainty is recorded below. |
| Full gripper travel | Continuous pure-translation separation covers 0–100 mm commands. Conservative opposed gap remains command + 1.994608484 mm. Five configurations at 0/25/50/75/100 check the service loops against both jaws, hardware and a conservative actuator box; no new interference is detected. |
| Cable motion allowance | Moving/service path lengths remain 71.690/219.309 mm. Tangents, fixed endpoints and constant combined length are checked at 101 commands. R25.7/R25 service turns and provisional external restraints are retained; no dynamic cable or fatigue simulation is implied. |
| Printable exports | Finger, gauge and coupon reimport as one valid STEP solid and one watertight STL body each, in native and print placements. Proper transforms and bed Z=0 pass. Main print envelope is 27 × 73.2 × 28 mm. STL units are millimetres by convention. |
| P2S PETG manufacturing | Side printing keeps dominant bending paths within layers. Minimum main web is 5 mm, service-window side material 4 mm and skin 3.5 mm vertically. Nominal core roof bridges are ≤12 mm; exposed supports remain accessible. Eight walls/100% infill are untested candidates; no slicer or physical print result is claimed. |
| Full assembly and previews | 0/50/100 GLBs contain 35 named components including the original actuator and cable routes. Reimported component vertices, faces and poses pass. Six-solid pair STEP and eight-solid cable STEP pass. Exploded, print, tool-access, same-scale comparison and actual-section views are supplied. |

The [mechanical comparison](mechanical-comparison.md) records assumptions, load sources, material reference, coupling sensitivity and representative root bolt loads. [Manufacturing notes](manufacturing.md) cover orientation, supports, hole compensation and assembly order. No allowable operating force, tightening torque, safety factor or fatigue life has been established.

STL export removes exactly **six zero-area UV-pole triangles** from each main finger mesh; no vertices move and no holes are filled. The service opening overlaps the core entrance by 1 mm, avoiding coincident fillet seams. Gauge/coupon meshes require no facet removal. Per-file counts are in the manifest. Assembly tessellation clears only the in-memory triangulation cache so prior STL meshing cannot change the preview/validation mesh. Original vendor files and archived exports are never repaired or rewritten.

Key views: [previous/reinforced](../drawings/v2_structural_comparison.png), [actual sections](../drawings/structural_sections.png), [closed](../drawings/assembly_open0.png), [mid-travel](../drawings/assembly_open50.png), [open](../drawings/assembly_open100.png), [exploded](../drawings/exploded.png), [root tool](../drawings/root_service_access.png), [accessible strain relief](../drawings/cable_strain_relief.png), [print orientation](../drawings/print_orientation.png).

The conservative rectangular plug is clear while mated. Its withdrawal box still clips **1.315747 mm³ of the vendor sensor housing**, exactly as in the previous V2; printed holder and screws remain clear. Actual stepped plug/latch geometry, selected port, harness sleeve/bend limits and fixed loom attachment need physical verification. The unchanged full-open cable envelope extends approximately X=±57.6 and Y=±138.3 mm; the proposed fixed endpoints are (±55, 0, 44.682) mm.

The existing [PRINT-HOLD.md](../../PRINT-HOLD.md) remains authoritative. The [physical checklist](../measurements/fit-checklist.md) records the outstanding fit, PETG bridge/support quality, actual stiffness, creep and fatigue checks. No slicing, full printing, physical load test or powered gripper command was performed. This completes the digital reinforcement and comparison, not a physical release.

## Explicit sensor-screw access follow-up

The [six-screw access report](sensor-screw-access.md) replaces the earlier assumed slim-driver check with catalog-reference screw heads, hex recesses, maximum under-head blends, a Ø3 mm / 60 mm driver and a declared handle envelope. All six unrelieved seats had 0.005042 mm³ interference with the maximum blend. Six 0.15 × 45° bore-mouth chamfers eliminate it, removing only 0.403043 mm³ from the reinforced finger and preserving the Z=11.8 seat and 1.4 mm nominal penetration. The fit coupon includes the same relief.

All six reference insertion, driver and removal paths pass on both attached fingers at 0/50/100 mm commands, including the moving blocks, other hardware, sensor housing, cable geometry and conservative complete-actuator envelope. Minimum free curved-surface clearance is 0.0354 mm at the blend; head and driver radial clearances are 0.100 mm. Required slender reach is 4.193/7.023/9.854 mm by row. The report distinguishes intended bearing/thread contact from unintended collision.

The user has no additional real screw/tool specification. **Overall actual-hardware status is UNVERIFIED for S1, S2, S3, S4, S5 and S6.** Usable full-flank engagement, printed fit, actual tool tip/handle and allowable tightening torque are not established by the nominal model. The existing print hold remains. The final normal build and both legacy regressions pass with this correction.
