MuX2001/cad-piper-paxini-adaptor/v2/revisions/before-short-sensor-pads/docs/validation-report.md

# Reinforced V2 — shallow-counterbore CAD audit — 2026-10-16

The existing reinforced V2 now has six local Ø7.2 mounting pads, **Ø4.2 × 2.0 mm shallow counterbores** and Ø2.1 screw passages. The **5 mm webs, 3.5 mm skins and 6 mm root seat remain unchanged**. Sensor alignment, cable routing, 70 mm functional reach and PiPER interfaces are preserved. No new variant or milestone was introduced.

The normal `v2/scripts/cad/build_v2.py` build and validation finished with **exit code 0**, including both original V1 clamp validators. [Machine results](validation.json) match the [source/export manifest](build-manifest.json). Outputs comprise **17 CAD/mesh exports, 23 PNG previews and five mechanical/access-analysis files**. The close-up and cross-section were visually reviewed.

| Verification | Result |
| --- | --- |
| Preservation | All 232 original files and both subsequent user inputs match their hashes. The earlier 47-file V2 snapshot remains intact. All **67 files** of the immediate prior reinforced V2 match [pre-counterbore-revision.json](pre-counterbore-revision.json). |
| Locality / structure | Exact B-rep differences contain **0 mm³ outside the six local pad zones** and no root/arm changes. Material added 1009.505 mm³, removed 19.722 mm³; net +989.783 mm³. All original load-bearing section dimensions are retained. |
| Shallow pockets / surrounding material | All six have exactly 2 mm counterbore depth, 1.5 mm radial rims and the retained 0.15 × 45° seating relief. Minimum continuous pocket floors are **6 / 10 / 14 mm** by row; effective under-head stacks are **6.6 / 10.6 / 14.6 mm**. |
| Screws / seating | S1/S4 M1.6×8; S2/S5 ×12; S3/S6 ×16. Reference Ø3 × 1.6 heads, hex sockets and maximum under-head blends seat without interference. The minimum ISO bearing annulus is fully supported. |
| Per-screw insertion / tool / removal | **S1 PASS, S2 PASS, S3 PASS, S4 PASS, S5 PASS, S6 PASS** for reference geometry. Continuous axial sweeps are checked on both attached jaw assemblies at 0/50/100 mm commands; sensor housing, retained blocks, other screws, cable geometry and conservative complete-actuator envelope are included. |
| Available clearance | Minimum screw-to-finger free clearance **0.1414 mm**, driver radial clearance **0.60 mm**. Deliberate seat and thread contact are excluded. Driver: 1.5 mm hex, Ø3 shaft, 60 mm blade; nominal socket engagement 0.7 and required slender reach 1.1 mm. |
| PETG sensitivity | With bores/pockets 0.30 mm undersize on diameter, every insertion and driver sweep still clears. Driver radial gap **0.45 mm**, shank 0.10, maximum knurled-head 0.38, blend minimum 0.0354 mm. These error bounds require physical calibration. |
| Thread depth | Manufacturer: six M1.6 tapped holes, **2 mm depth**. Nominal penetration 1.4 and depth margin 0.6 mm. Screw-length tolerance plus assumed ±0.15 mm printed-stack error leaves **0.16 / 0.10 / 0.10 mm** depth margin by row. Actual usable thread engagement, depth tolerances and allowable torque are UNVERIFIED. |
| Unchanged datums | All six source STEP axes match the 17.5 × 8 mm pattern within its drawing rounding. Sensor plane Z=9.2 and the original 70.000 mm tactile reach remain fixed. Both original four-hole root patterns match. |
| Root access | Full head-bearing annuli through the 6 mm seat pass. Candidate M2×8 maintains 2 mm nominal penetration. Four head-insertion paths and short L-key turns 0–60° in 5° steps remain clear. |
| Sensor and cable service | Conservative sensor removal sweep 12 mm toward the gap clears the holder. Parallel DF53 orientation, 12 mm straight lead run, R38 bend, open saddle and service loops are unchanged. |
| Motion | Continuous translation separation covers commands 0–100. Opposed sensor-envelope gap remains command + 1.994608484 mm. Five full configurations check the service loops and actuator separation; constant path length is checked at 101 commands. |
| CAD / mesh exports | Finger, gauge and coupon reimport as valid single STEP solids and watertight single STL bodies. Bed placements and rigid transforms pass. Finger volume **23476.157 mm³**, STL volume error **0.0083%**. Print envelope remains 27 × 73.2 × 28 mm. |
| Complete assemblies | Normal assemblies contain 35 named components, including the unchanged actuator, original retained blocks, sensors and cable route; reimported vertices/faces/transforms pass. Pair STEP has 6 solids; cable STEP 8. The access study reimports as 21 valid solids with all 18 screw/path/tool volumes matching source; complete access GLB has 42 named components. |
| Structural comparison | The existing matched beam calculation was regenerated for the actual revised solid: 201.9 N/mm ideal gripping stiffness, 0.1238 mm deflection at representative 25 N, versus 185.3 N/mm and0.1349 mm for the immediate prior reinforced solid. Main mid-span section is unchanged. No physical strength rating follows. |

Full per-screw values, hardware sources, limits and geometry are in [sensor-screw-access.md](sensor-screw-access.md) and [its JSON](sensor-screw-access.json). **Actual hardware status is UNVERIFIED separately for S1, S2, S3, S4, S5 and S6.** No additional supplied screw/tool specification exists. The driver handle diameter is an explicit assumed envelope; reduced-tip details, usable thread depth, safe torque and printed fit remain unconfirmed.

Key deliverables: [updated STEP](../cad/exported/replacement_finger.step), [print-oriented STL](../cad/exported/replacement_finger_print.stl), [counterbore section](../drawings/sensor_screw_seating.png), [six paths](../drawings/sensor_screw_access.png), [complete driver/assembly CAD](../cad/exported/sensor_screw_access.glb), [local access STEP](../cad/exported/sensor_screw_access.step). [Manufacturing notes](manufacturing.md) specify row lengths, support access and the updated coupon. Keep lengths segregated and measure screw protrusion before assembly.

STL cleanup removes six zero-area UV-pole facets from each main finger mesh without moving vertices or filling holes; gauge/coupon meshes need no removal. Original vendor assets and archived outputs are never repaired or overwritten.

The inherited conservative plug-withdrawal box still clips 1.315747 mm³ of the vendor sensor housing, unchanged from the previous V2; printed holder and screws remain clear. Actual stepped plug/latch geometry remains a physical check. The existing [PRINT-HOLD](../../PRINT-HOLD.md) and [physical checklist](../measurements/fit-checklist.md) remain in force. No slicing, physical print/load test or powered gripper command was performed.
