MuX2001/cad-piper-paxini-adaptor/v2/revisions/goal-02/measurements/fit-checklist.md

# V2 physical verification — blank / not performed

Keep V1 measurements and parameters unchanged. Record the V2 build-manifest hash, model parameters, printer profile, material, orientation and date for each fit check. Existing `../../PRINT-HOLD.md` remains authoritative; no new full-print release is recorded here.

| Required before full printing / operation | Result |
| --- | --- |
| Both moving blocks match 17 × 22.5 mm faces and 12 × 8 mm four-hole pattern | Pending |
| Both stock fingers can be removed whole without opening/modifying actuator or linkage | Pending |
| Carrier thread diameter, pitch, full usable depth, original screw dimensions; confirm or replace inferred M2 | Pending |
| Root gauge face sits flush; all four axes align without forcing; central feature remains clear | Pending |
| Candidate root screw heads/driver fit; 2 mm nominal engagement neither bottoms nor is insufficient | Pending |
| Both modules are M2324; six M1.6 axes, flat rear strips and permissible screw depth agree | Pending |
| M1.6×4 actual head fits Ø3.2 pocket; 1.4 mm nominal penetration is appropriate | Pending |
| Chosen IN/OUT port, plug width/length/height, latch access and mating direction photographed/measured | Pending |
| Actual loose-lead bundle/sleeve fits the assumed 5.2 × 1 mm envelope; manufacturer minimum bend radius obtained or approved bend allowance established | Pending |
| Exposed plug fits the catalog-derived 6.5 × 1.4 × 1.35 mm envelope; 12 mm parallel lead run and straight unplug access remain clear after printing | Pending |
| Actual stepped plug clears the sensor housing during unplugging; resolve the conservative full-box sweep's 1.316 mm³ vendor-housing overlap and verify latch access | Pending |
| Open saddle, protective sleeve and releasable 2.5 mm tie restrain leads without crushing them or loading the plug | Pending |
| R38 moving sweep and R25.7 / R25 service turns accommodate each jaw's 50 mm travel without rubbing/pulling; approximately 291 mm modeled cable length available | Pending |
| Suitable fixed loom restraints available at provisional base (±55, 0, 44.682) mm; full-open X ±57.6 / Y ±138.3 mm cable region is unobstructed | Pending |
| Both tactile crowns physically align with the original 70 mm reach datum; mounting flatness and opposing contact alignment checked | Pending |
| Fastener coupon lanes: nominal, +0.1, +0.2 mm; hole/head-pocket fit and material/process recorded | Pending |
| Printed root/sensor datums remain flat after support removal; ribs and small webs have no defects | Pending |
| Required grip force, permissible torque, stiffness/load trial and material creep reviewed | Pending |
| Physical zero/opening calibration and sensor-to-sensor clearance checked unpowered | Pending |
| Full-print/operation release explicitly reviewed after the above data | Not released |

No live gripper command, automatic parameter update or release is implied by completing this form. Gauge/coupon files are digital proposals for unpowered fit testing; the existing hold's approved list is unchanged.
