MuX2001/cad-piper-paxini-adaptor/v2/revisions/before-geometry-simplification/docs/section-properties.csv

revision | y_mm | area_mm2 | centroid_x_mm | centroid_z_mm | Ixx_mm4 | Izz_mm4 | product_xz_mm4 | polar_area_moment_mm4 | effective_I_grip_mm4 | effective_I_lateral_mm4 | independent_faces_I_grip_mm4 | independent_faces_I_lateral_mm4 | nominal_normal_stress_mpa | nominal_lateral_stress_mpa | connected_faces | inner_loops
previous | -69.75 | 599.3380557009634 | -3.3788056300677694e-16 | 15.312901248276294 | 26154.04638718115 | 40489.47857021075 | -7.276417873540322e-14 | 66643.5249573919 | 26154.04638718115 | 40489.47857021075 | 26154.04638718115 | 40489.47857021075 | 0.7542569612230441 | 0.2411737652552628 | 1 | 5
previous | -69.25 | 599.3380557009634 | -3.3788056300677694e-16 | 15.312901248276294 | 26154.04638718115 | 40489.47857021075 | -7.276417873540322e-14 | 66643.5249573919 | 26154.04638718115 | 40489.47857021075 | 26154.04638718115 | 40489.47857021075 | 0.7488501012859612 | 0.23944492105988457 | 1 | 5
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
