MuX2001/cad-piper-paxini-adaptor/v2/revisions/before-geometry-simplification/drawings/cable_exit_side.png

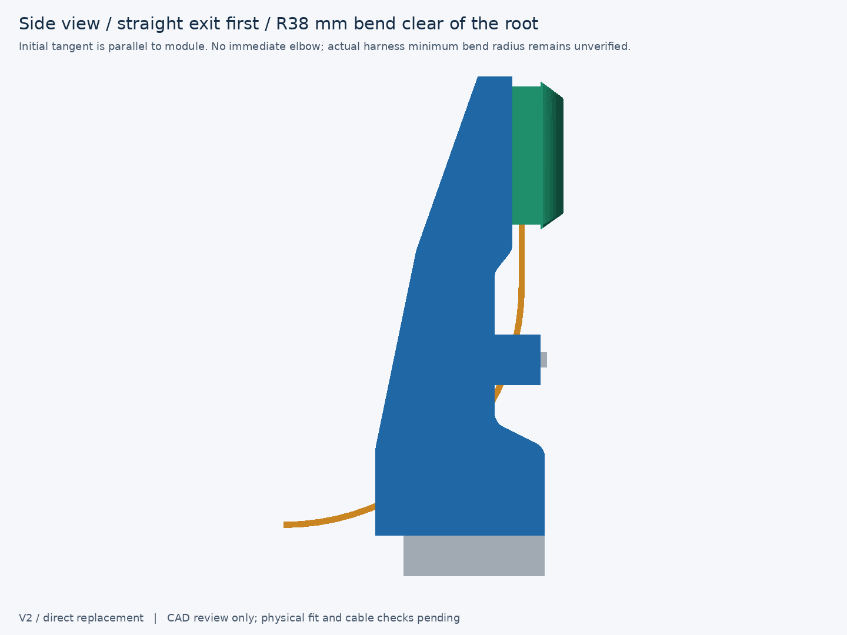
v2/revisions/before-geometry-simplification/drawings/cable_exit_side.png
