MuX2001/cad-piper-paxini-adaptor/v2/revisions/before-geometry-simplification/drawings/cable_routing.png

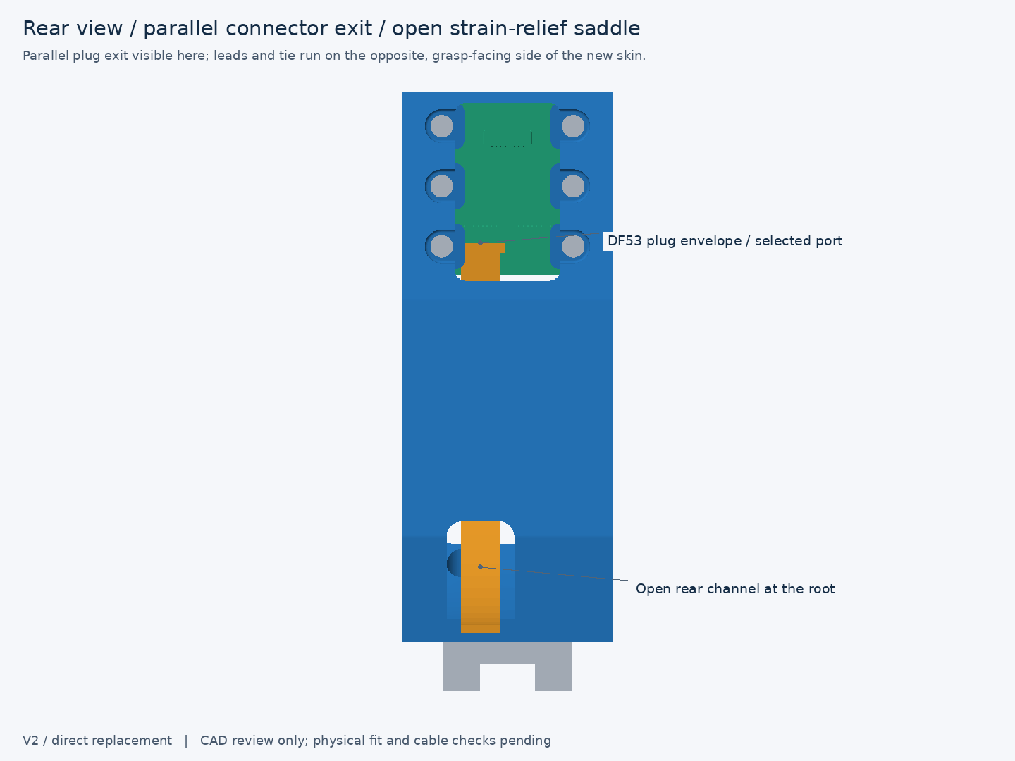
v2/revisions/before-geometry-simplification/drawings/cable_routing.png
