MuX2001/cad-piper-paxini-adaptor/v2/revisions/before-geometry-simplification/drawings/mounting_interface.png

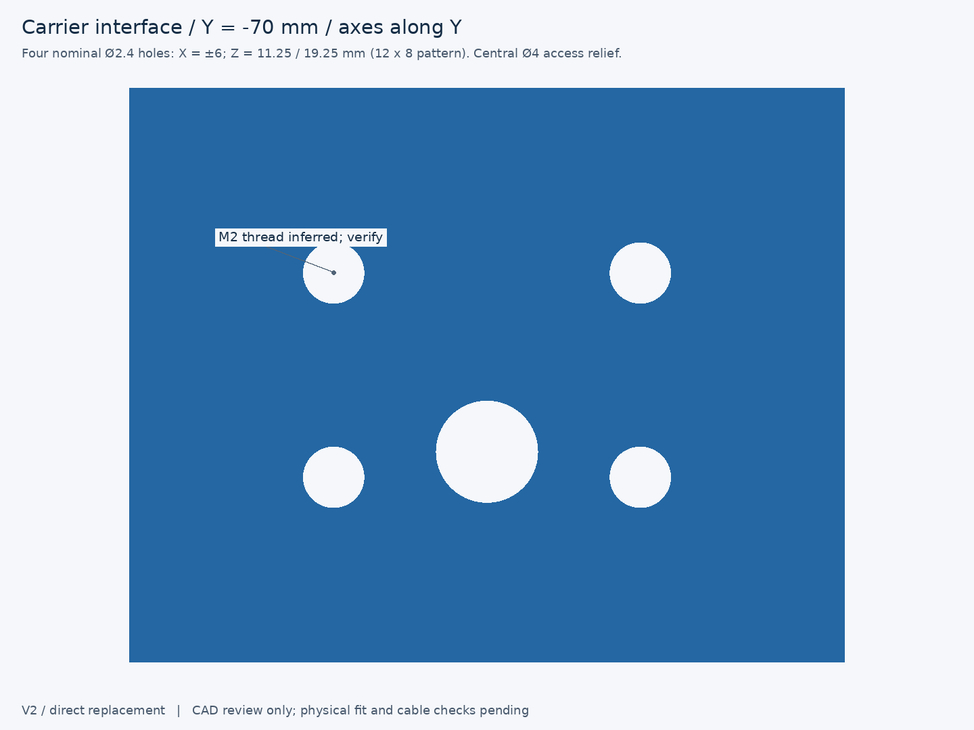
v2/revisions/before-geometry-simplification/drawings/mounting_interface.png
