MuX2001/cad-piper-paxini-adaptor/v2/revisions/before-geometry-simplification/drawings/opposed_sensors.png

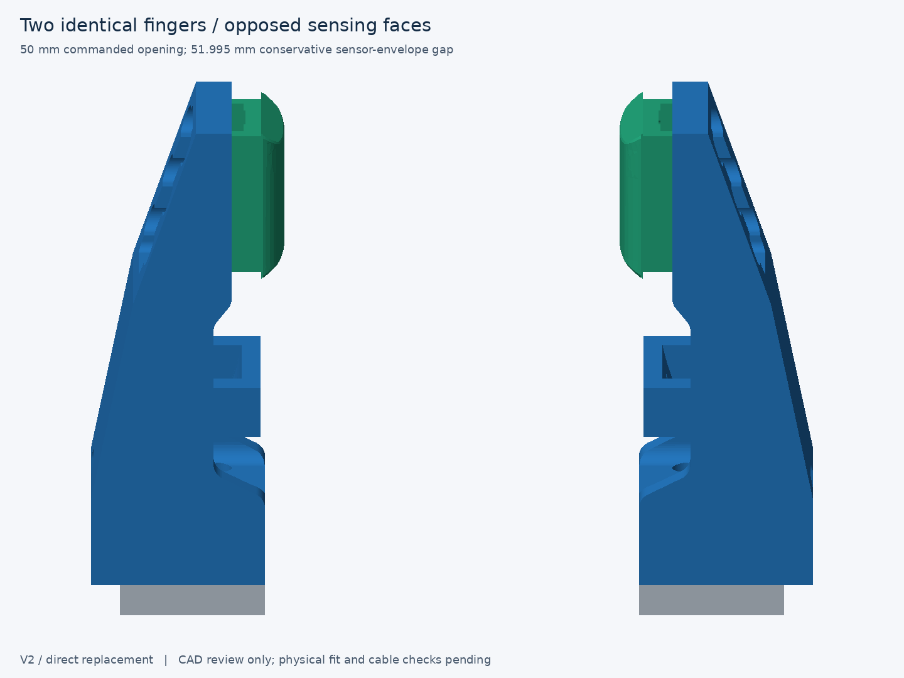
v2/revisions/before-geometry-simplification/drawings/opposed_sensors.png
