MuX2001/cad-piper-paxini-adaptor/v2/revisions/before-geometry-simplification/drawings/reference_carrier.png

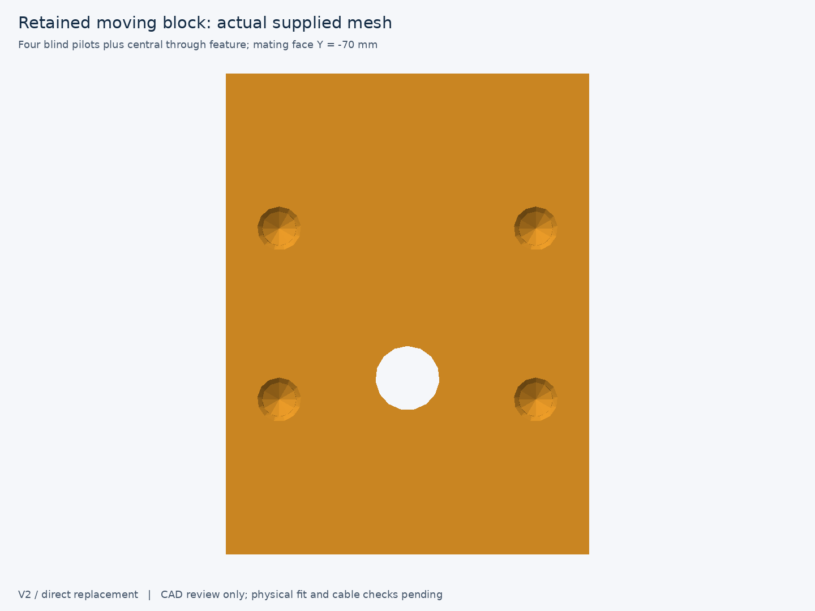
v2/revisions/before-geometry-simplification/drawings/reference_carrier.png
