MuX2001/cad-piper-paxini-adaptor/v2/revisions/before-geometry-simplification/drawings/reference_finger.png

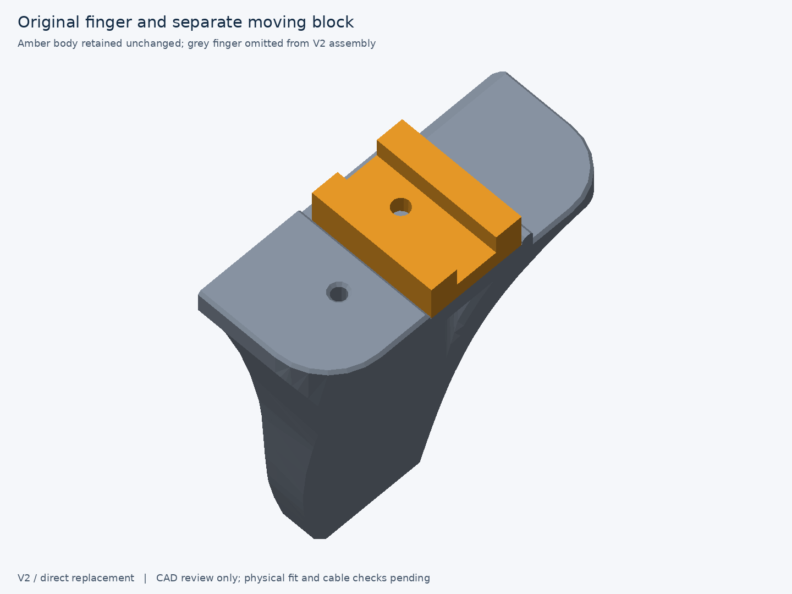
v2/revisions/before-geometry-simplification/drawings/reference_finger.png
