MuX2001/cad-piper-paxini-adaptor/v2/revisions/before-geometry-simplification/drawings/replacement_finger.png

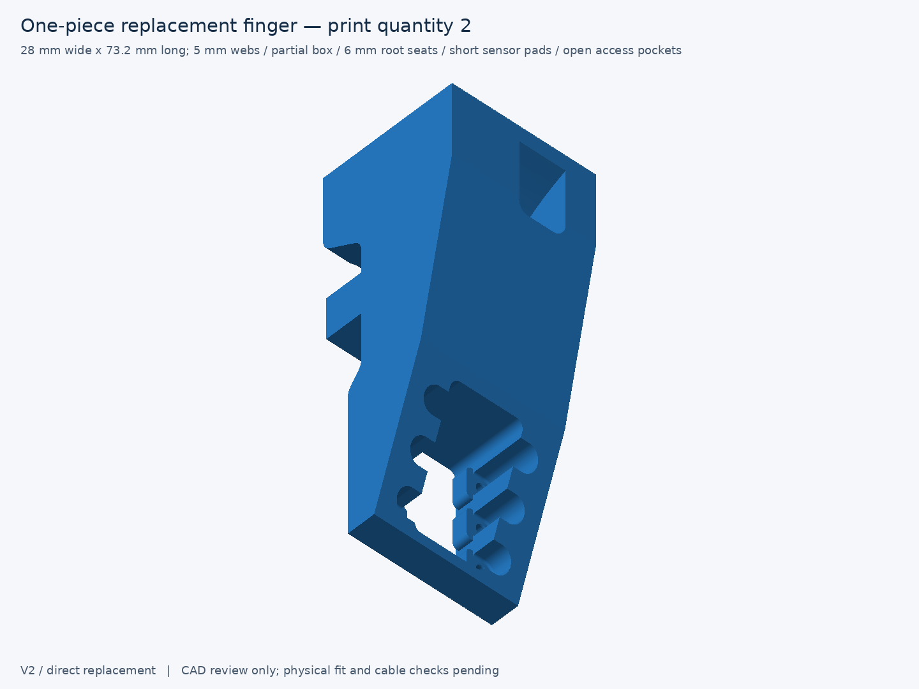
v2/revisions/before-geometry-simplification/drawings/replacement_finger.png
