MuX2001/cad-piper-paxini-adaptor/v2/revisions/before-geometry-simplification/drawings/root_service_access.png

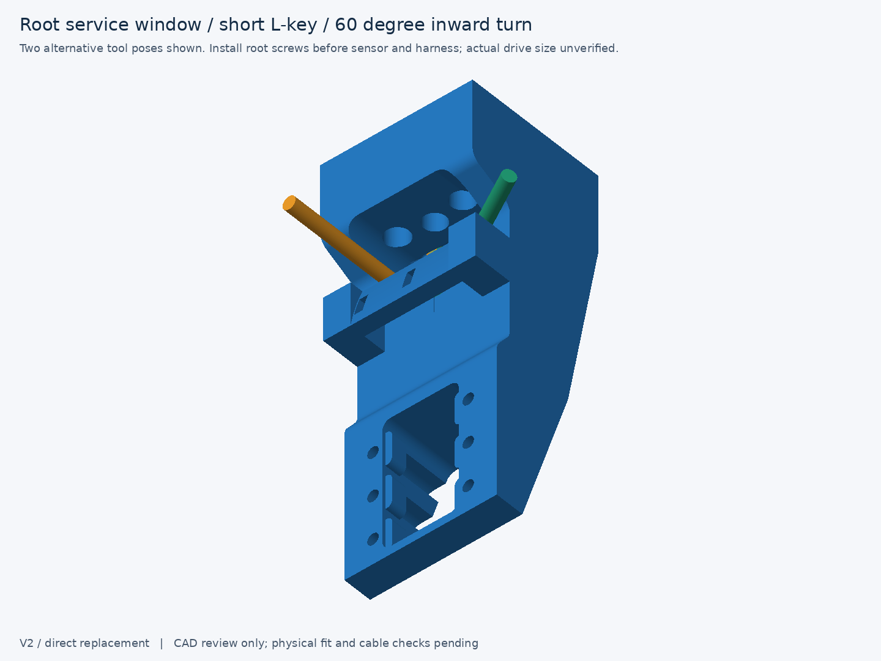
v2/revisions/before-geometry-simplification/drawings/root_service_access.png
