MuX2001/cad-piper-paxini-adaptor/v2/revisions/before-geometry-simplification/drawings/sensor_screw_access.png

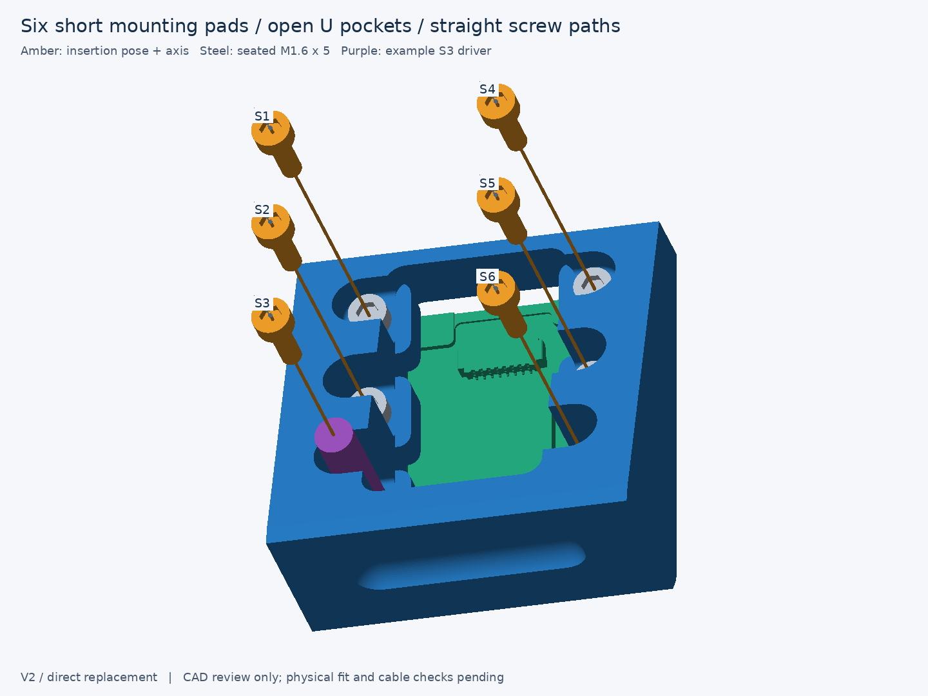
v2/revisions/before-geometry-simplification/drawings/sensor_screw_access.png
