MuX2001/cad-piper-paxini-adaptor/v2/revisions/before-geometry-simplification/drawings/service_loops.png

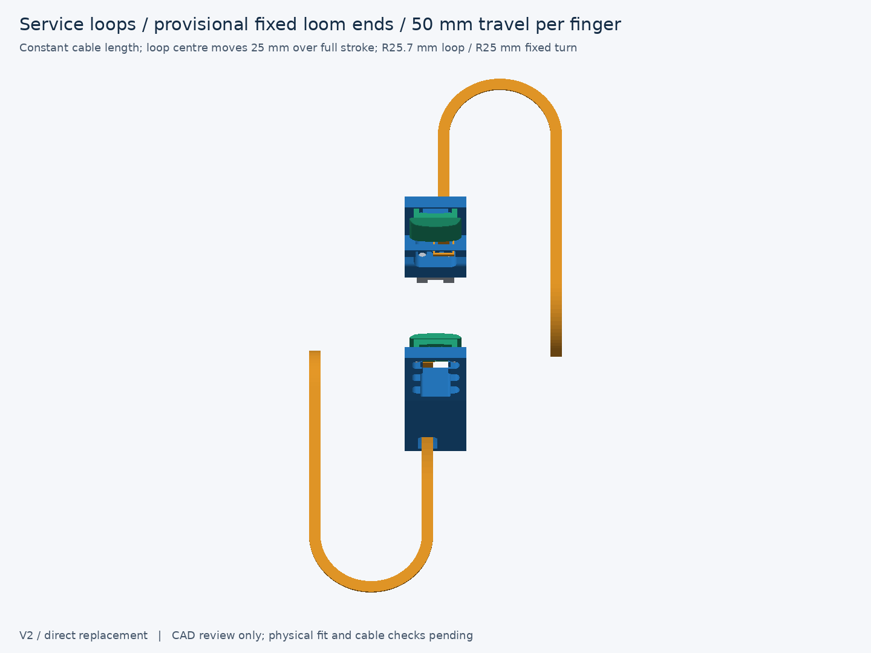
v2/revisions/before-geometry-simplification/drawings/service_loops.png
