MuX2001/cad-piper-paxini-adaptor/v2/revisions/before-geometry-simplification/drawings/structural_sections.png

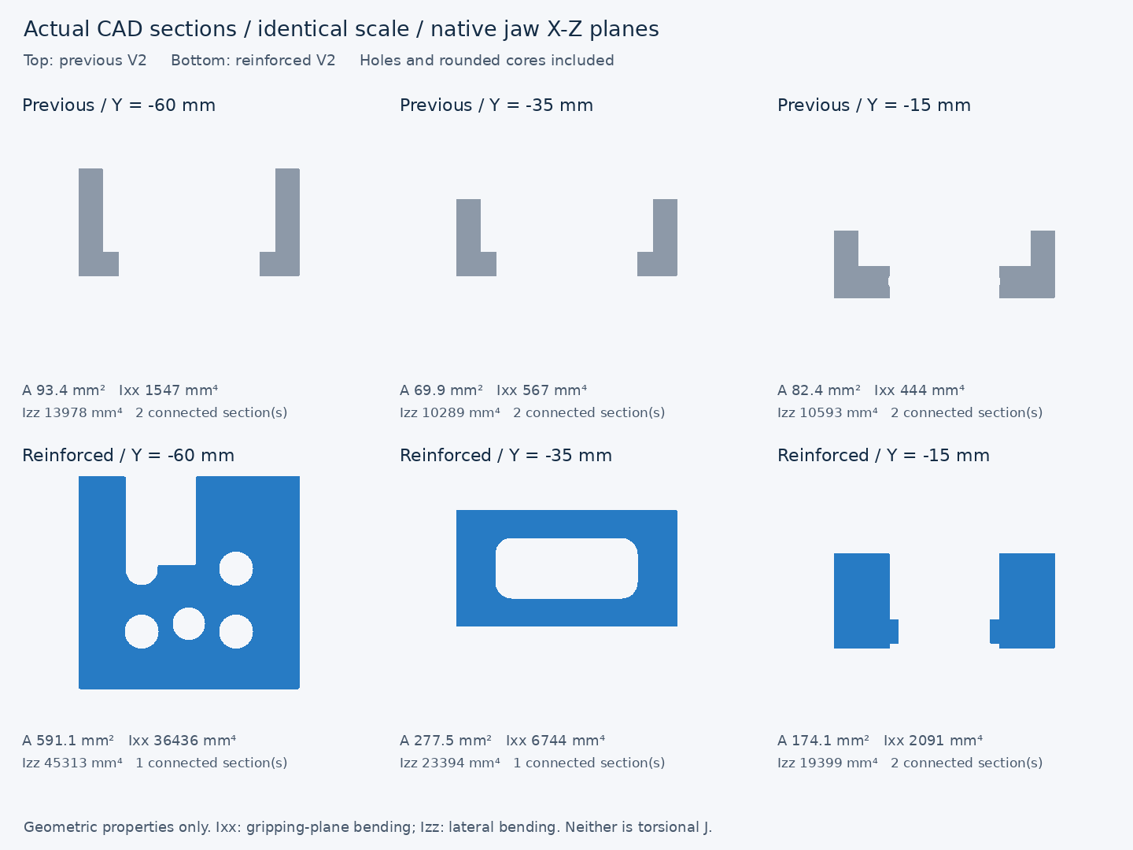
v2/revisions/before-geometry-simplification/drawings/structural_sections.png
