MuX2001/cad-piper-paxini-adaptor/v2/revisions/before-geometry-simplification/drawings/v2_structural_comparison.png

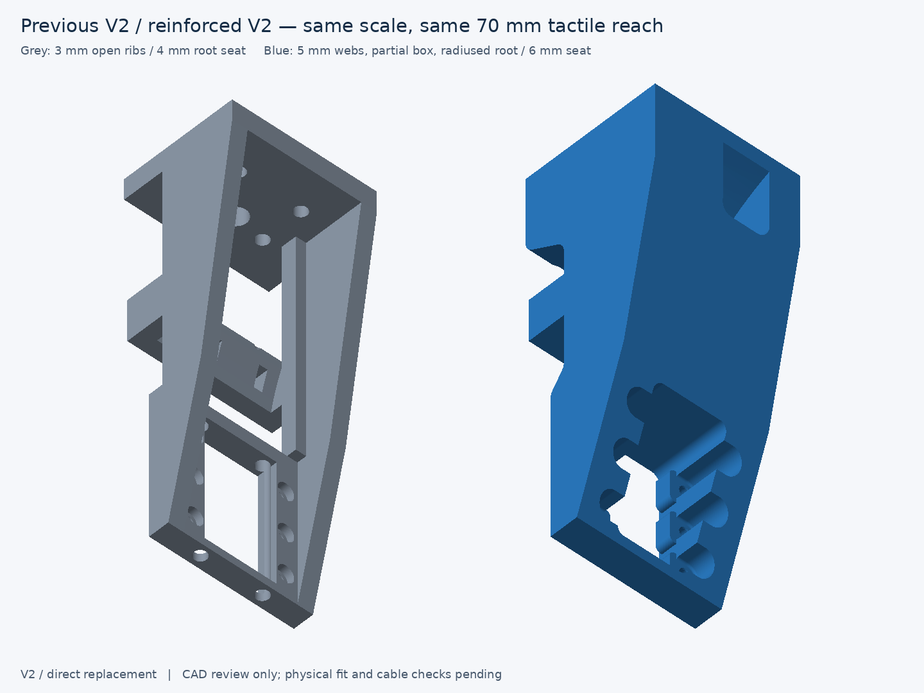
v2/revisions/before-geometry-simplification/drawings/v2_structural_comparison.png
