MuX2001/cad-piper-paxini-adaptor/v2/revisions/before-shallow-counterbores/drawings/sensor_screw_access.png

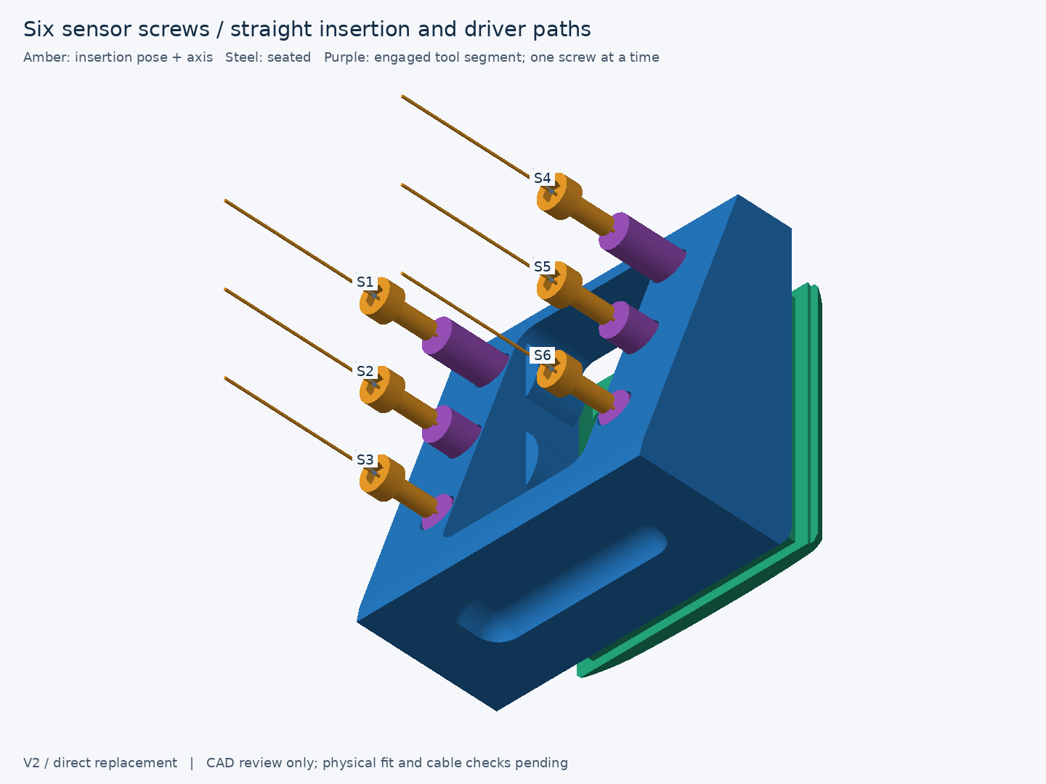
v2/revisions/before-shallow-counterbores/drawings/sensor_screw_access.png
