MuX2001/cad-piper-paxini-adaptor/v2/revisions/before-short-sensor-pads/drawings/sensor_screw_access.png

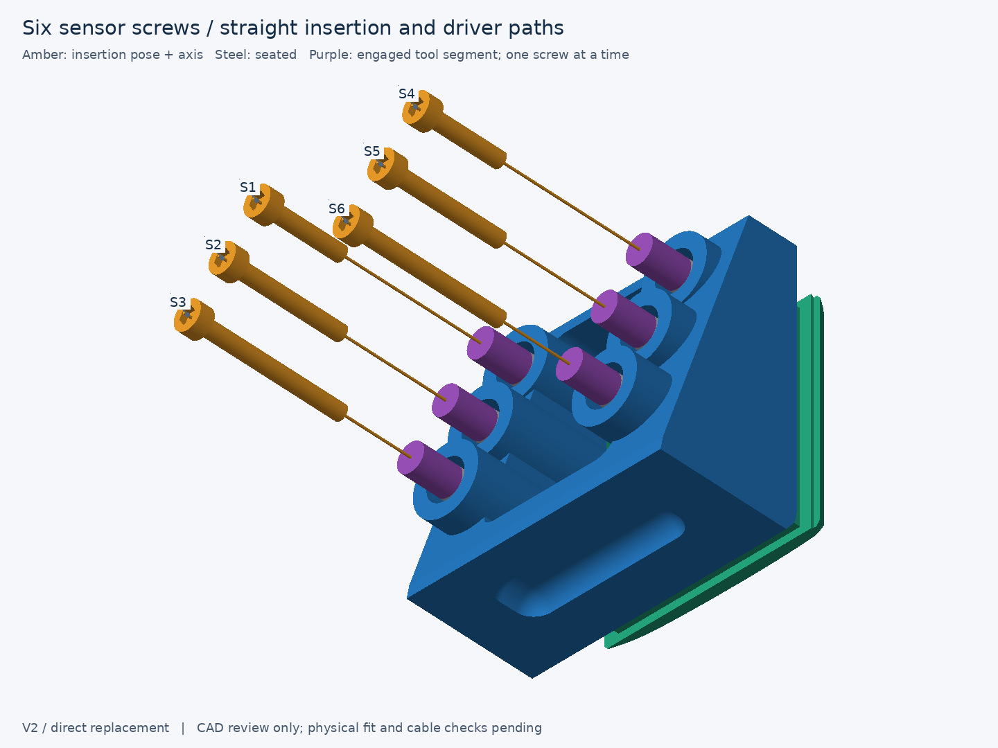
v2/revisions/before-short-sensor-pads/drawings/sensor_screw_access.png
