MuX2001/cad-piper-paxini-adaptor/v2/revisions/goal-02/drawings/cable_routing.png

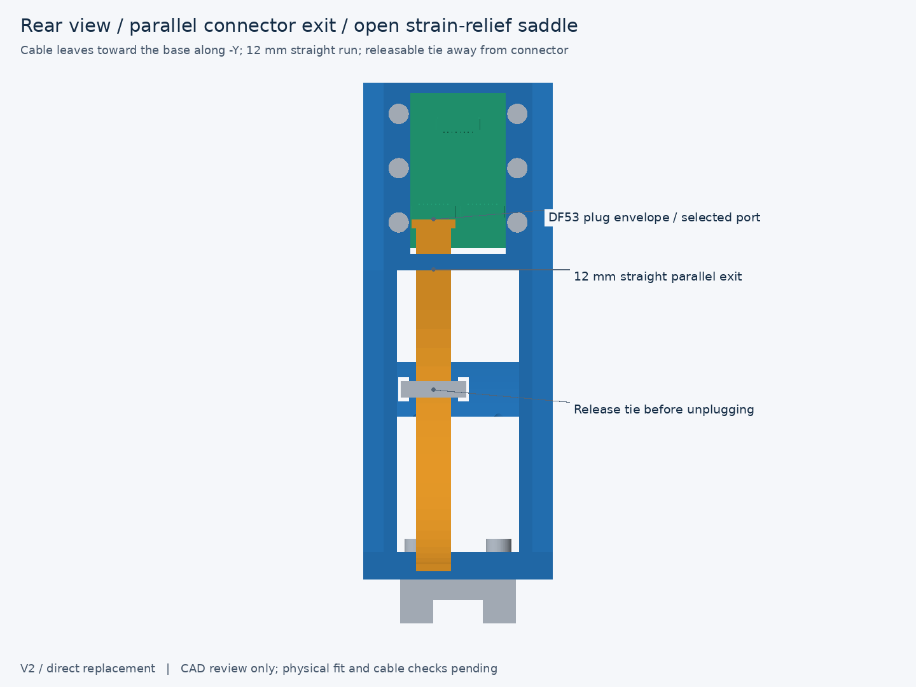
v2/revisions/goal-02/drawings/cable_routing.png
