MuX2001/cad-piper-paxini-adaptor/v2/revisions/goal-02/drawings/sensor_mount.png

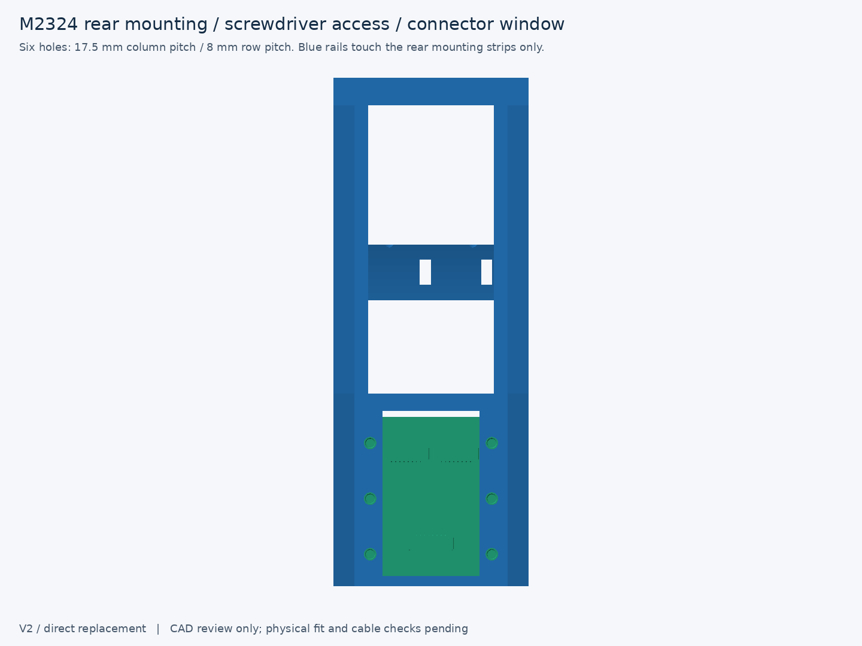
v2/revisions/goal-02/drawings/sensor_mount.png
